PingguSoft/PLEN2/assembly/arm/dsc00886.jpg

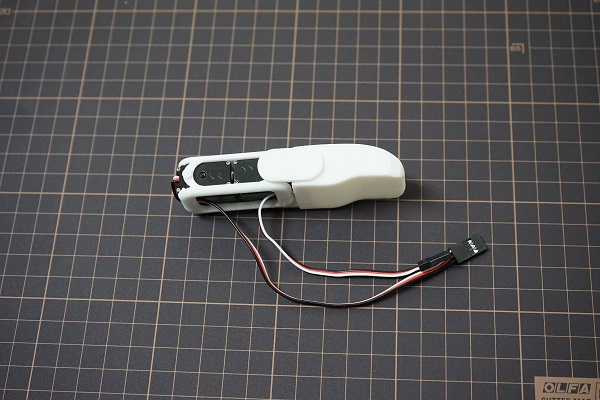
assembly/arm/dsc00886.jpg
