PingguSoft/PLEN2/assembly/arm/dsc00869.jpg

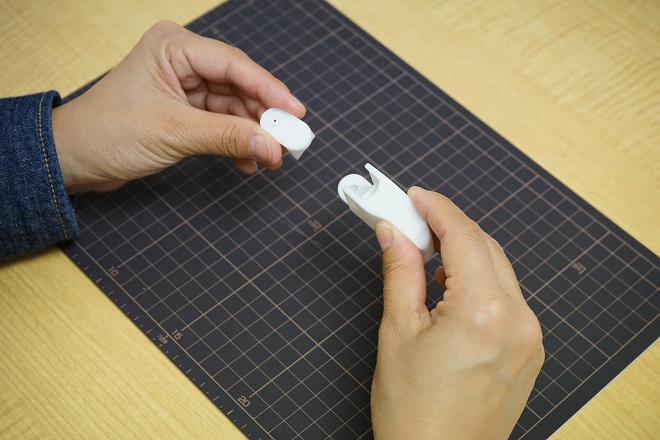
assembly/arm/dsc00869.jpg
