PingguSoft/PLEN2/src/README.md

PLEN2 - Firmware for Arduino (Atmega32u4)
================================================================================

Code name "Cytisus" (version 1.3.0) is now available!

Attention!
---
"Arduino" means compatible board created by us.
Please get it [here](http://shop.plen.jp/) or create yourself.

Copyright (c) 2015,
---
- [Kazuyuki TAKASE](https://github.com/Guvalif), Project manager of the repository.
- [PLEN Project Company Ltd.](http://plen.jp)

API Guide
---
Please check [here](https://plenproject.github.io/plen__firmware_for_Arduino).

Build Enviroment
---
- Windows 8.1 Professional edition
- Windows 7 Home Premium
- Arduino IDE ver.1.6.5-r5
- Sublime Text 3 Build 3083
- [Arduino Unit](https://github.com/mmurdoch/arduinounit)

License
---
This software is released under the MIT License.
