PingguSoft/PLEN2/schematic/esp8266-nodemcu-dev-kit-v1-pins.png

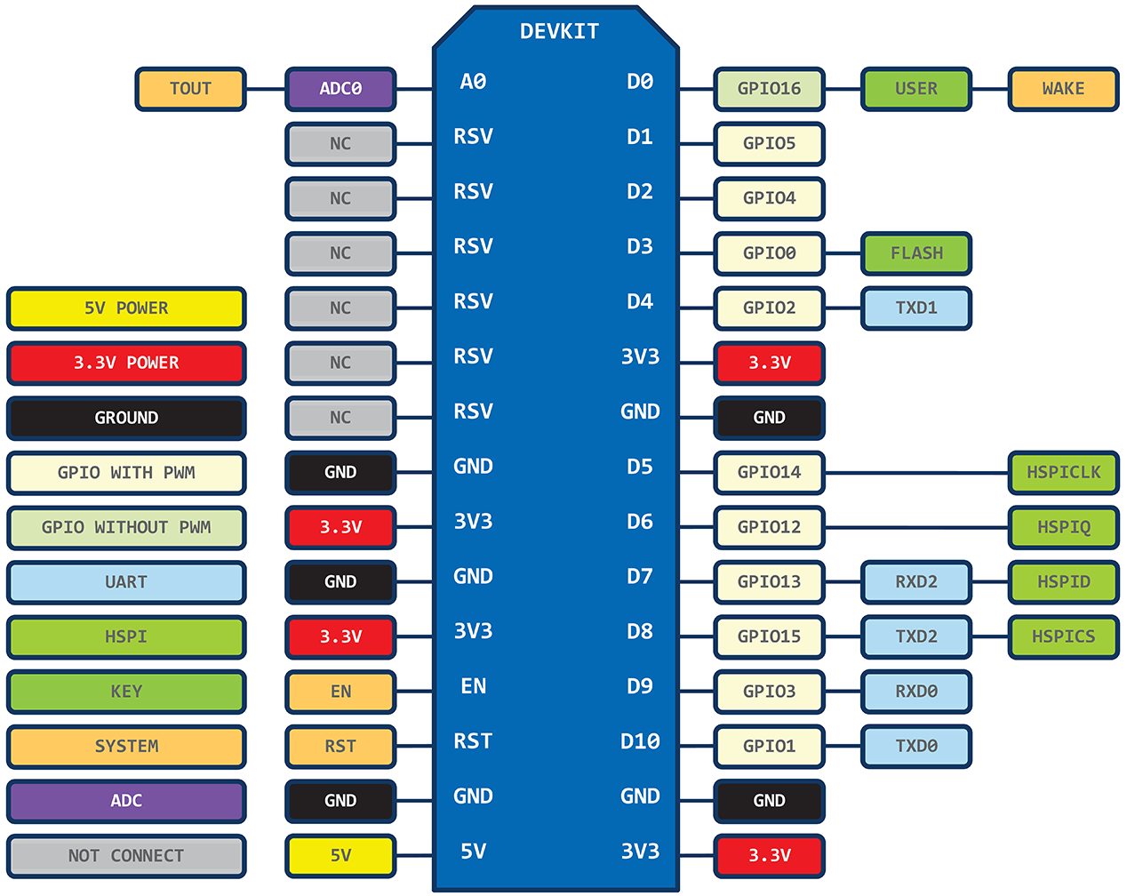
schematic/esp8266-nodemcu-dev-kit-v1-pins.png
