PingguSoft/PLEN2/schematic/loose_board-set.jpg

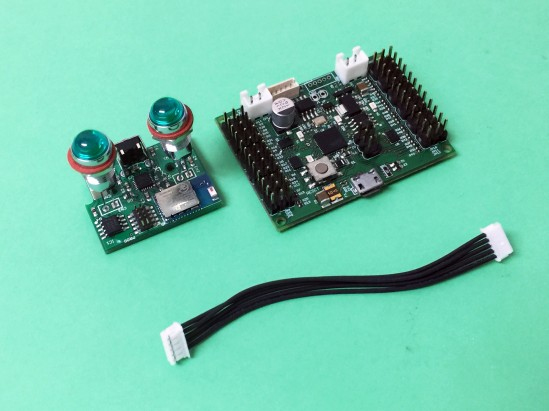
schematic/loose_board-set.jpg
