PingguSoft/PLEN2/schematic/loose_control-board.jpg

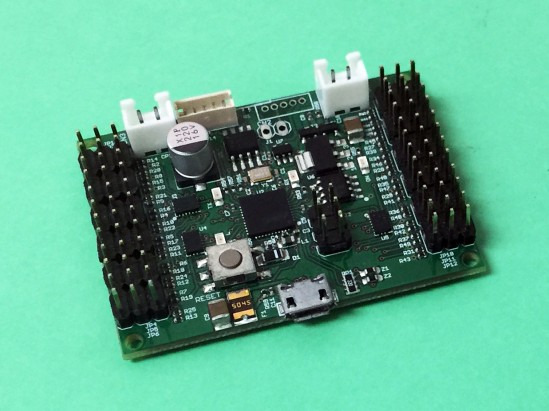
schematic/loose_control-board.jpg
