PingguSoft/PLEN2/schematic/motor_spec/ASV-15-zu1.png

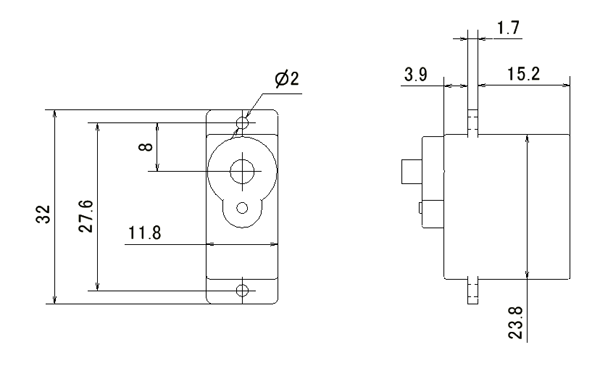
schematic/motor_spec/ASV-15-zu1.png
