PingguSoft/PLEN2/schematic/motor_spec/ASV-15-zu2.png

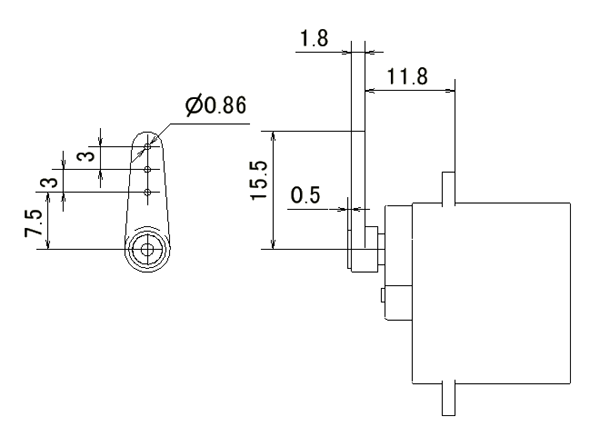
schematic/motor_spec/ASV-15-zu2.png
