PingguSoft/PLEN2/schematic/motor_spec/ASV-15-zu3.png

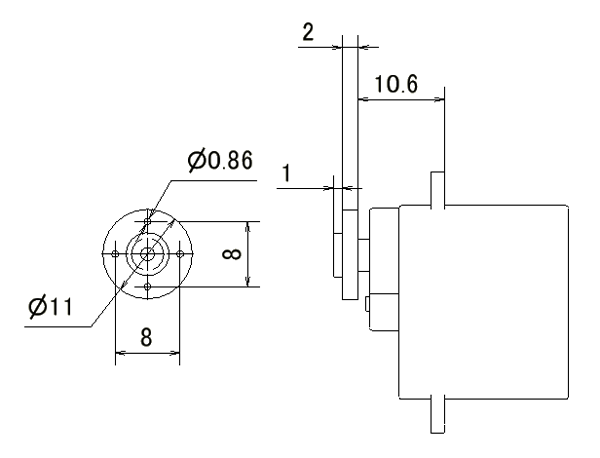
schematic/motor_spec/ASV-15-zu3.png
