PingguSoft/PLEN2/schematic/motor_spec/EMX-SV-0276-DES-1.jpg

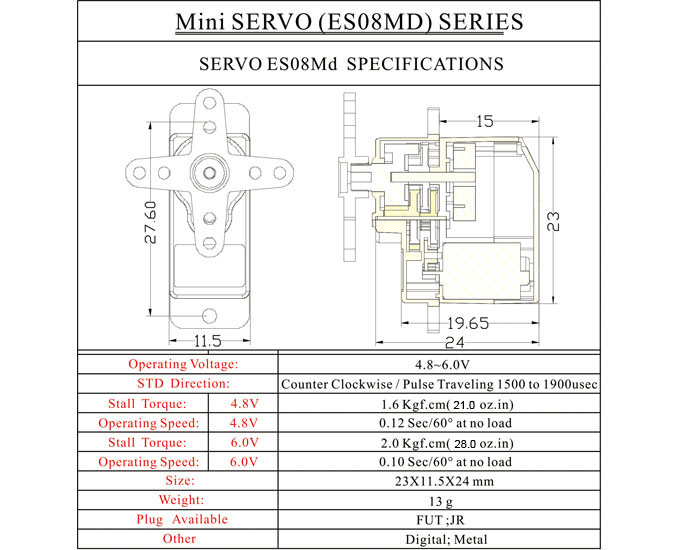
schematic/motor_spec/EMX-SV-0276-DES-1.jpg
