PingguSoft/PLEN2/stl/servo_bracket_shin.stl

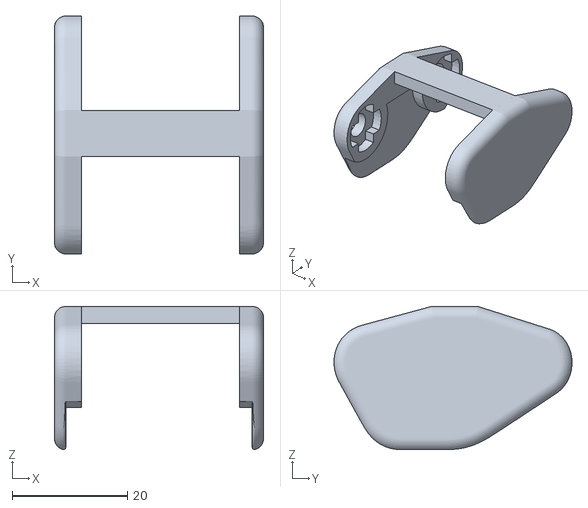
[picture p10: CAD file, 2015-11-30]
stl/servo_bracket_shin.stl
36.4 x 41.4 x 24.9
