PingguSoft/PLEN2/stl/servo_bracket_ankle_2.stl

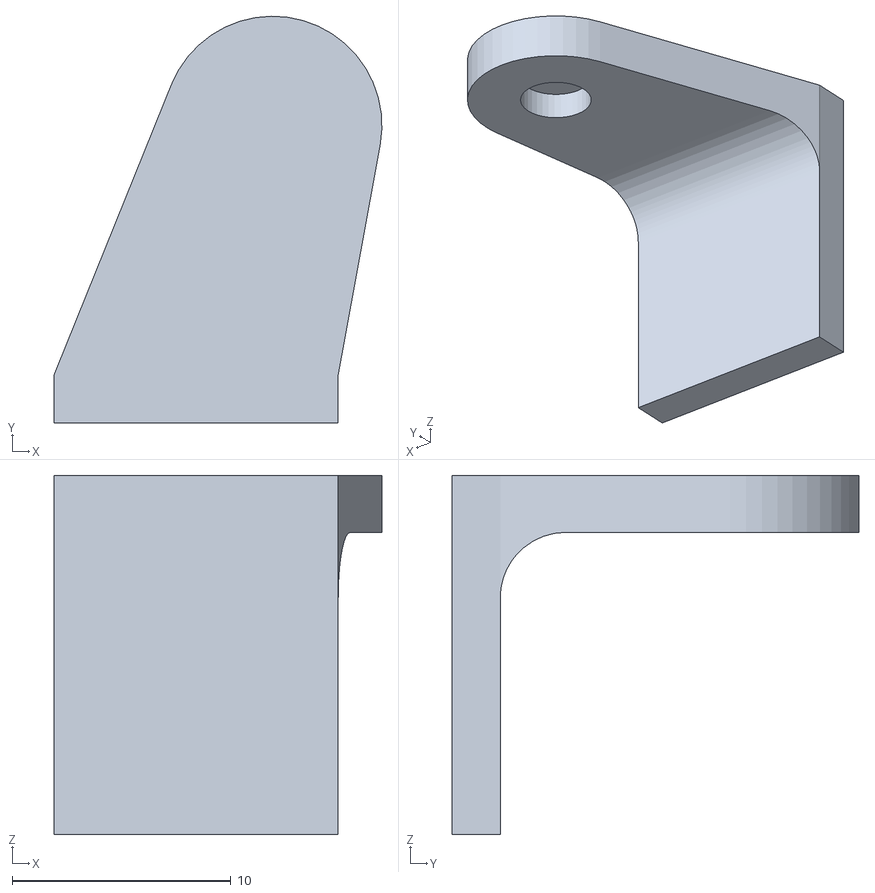
[picture p11: CAD file, 2015-11-30]
stl/servo_bracket_ankle_2.stl
15.0 x 18.6 x 16.4
