PingguSoft/PLEN2/stl/foot.stl

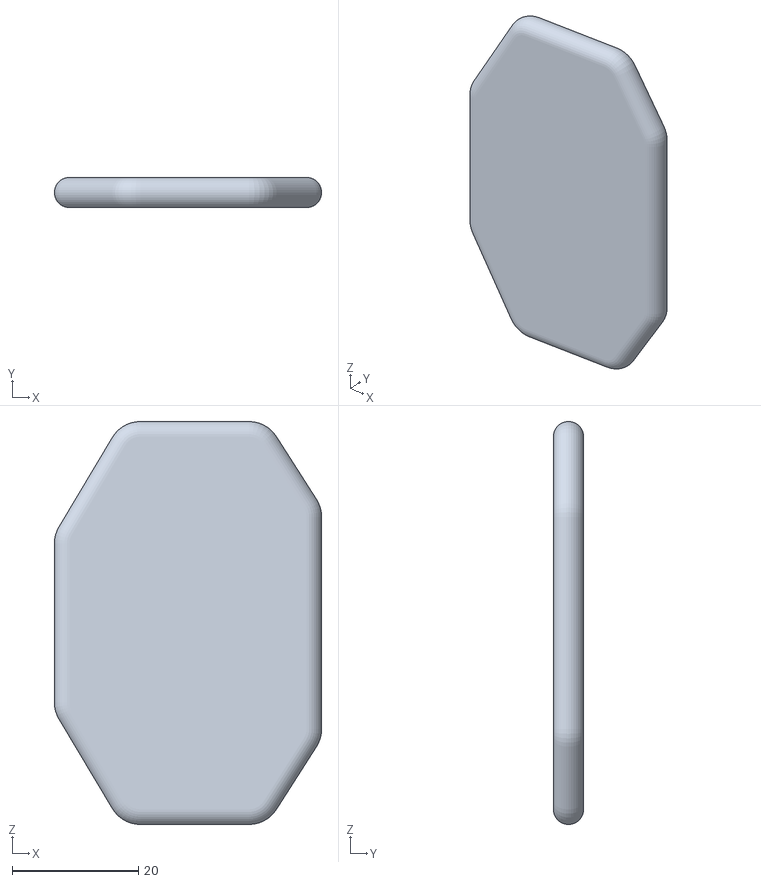
[picture p12: CAD file, 2015-11-30]
stl/foot.stl
42.4 x 4.80 x 63.9
