PingguSoft/PLEN2/stl/servo_bracket_hand.stl

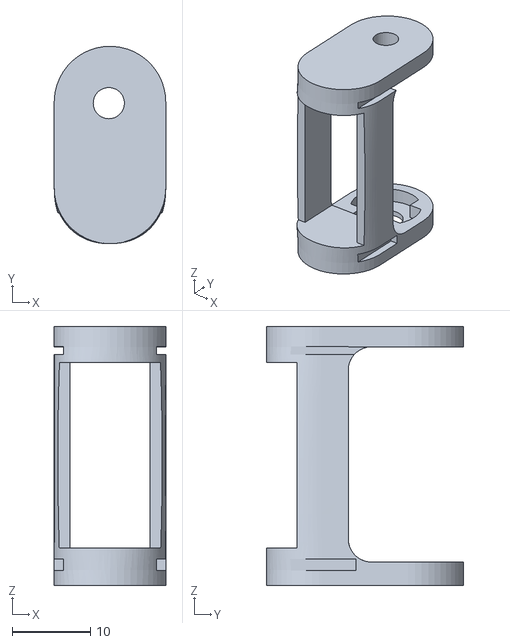
[picture p13: CAD file, 2015-11-30]
stl/servo_bracket_hand.stl
14.3 x 25.3 x 33.2
