PingguSoft/PLEN2/stl/servo_assem_type2.stl

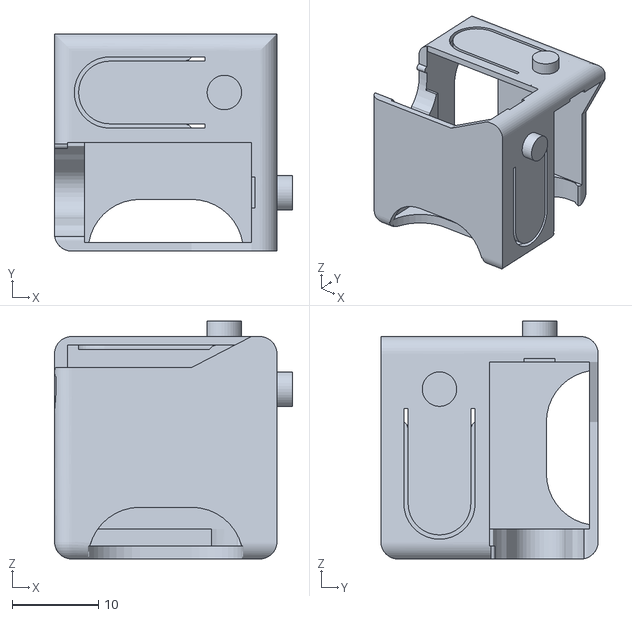
[picture p14: CAD file, 2015-11-30]
stl/servo_assem_type2.stl
27.6 x 25.2 x 27.6
