PingguSoft/PLEN2/stl/neck_rev2.stl

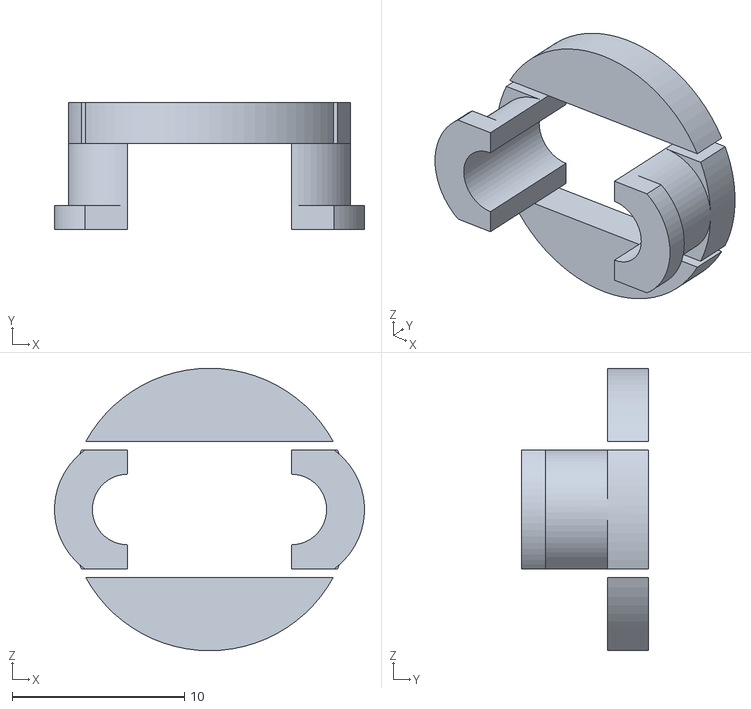
[picture p15: CAD file, 2015-11-30]
stl/neck_rev2.stl
18.0 x 7.40 x 16.4
