PingguSoft/PLEN2/stl/servo_assem_type1.stl

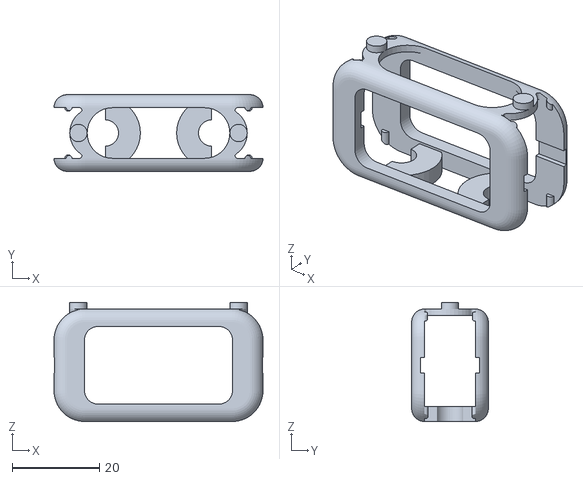
[picture p16: CAD file, 2015-11-30]
stl/servo_assem_type1.stl
47.9 x 17.6 x 27.3
