PingguSoft/PLEN2/stl/chest_0_05.stl

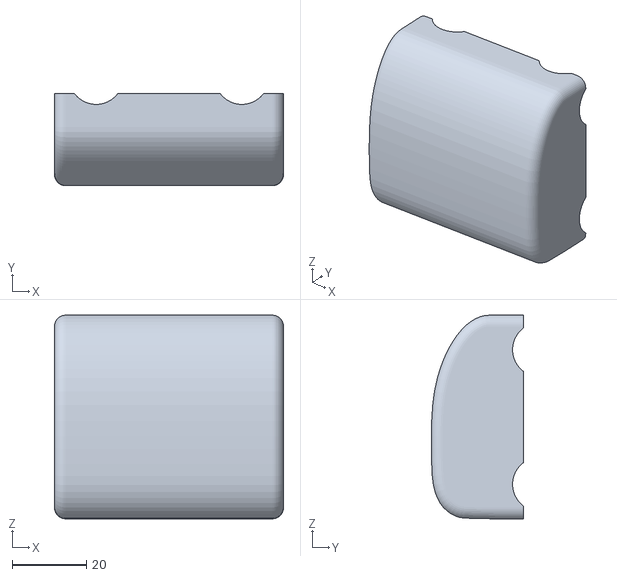
[picture p17: CAD file, 2015-11-30]
stl/chest_0_05.stl
61.6 x 24.9 x 54.8
