PingguSoft/PLEN2/stl/servo_bracket_type1.stl

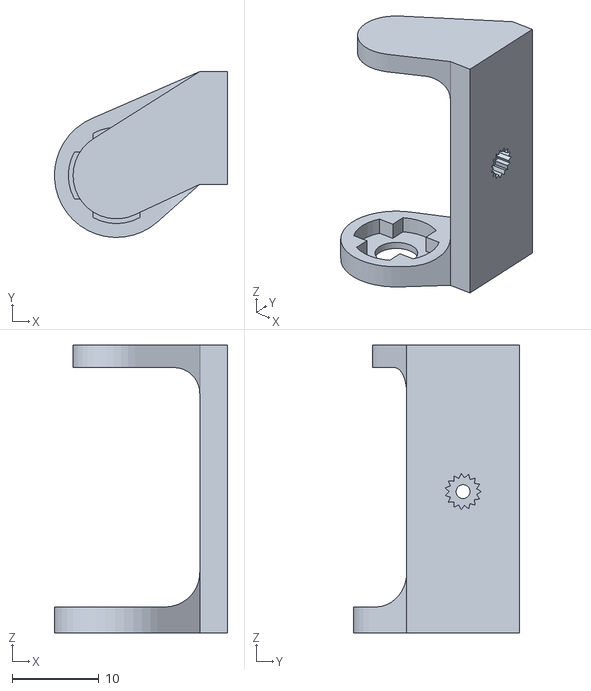
[picture p18: CAD file, 2015-11-30]
stl/servo_bracket_type1.stl
19.9 x 19.1 x 33.2
