PingguSoft/PLEN2/stl/PLEN2.stl

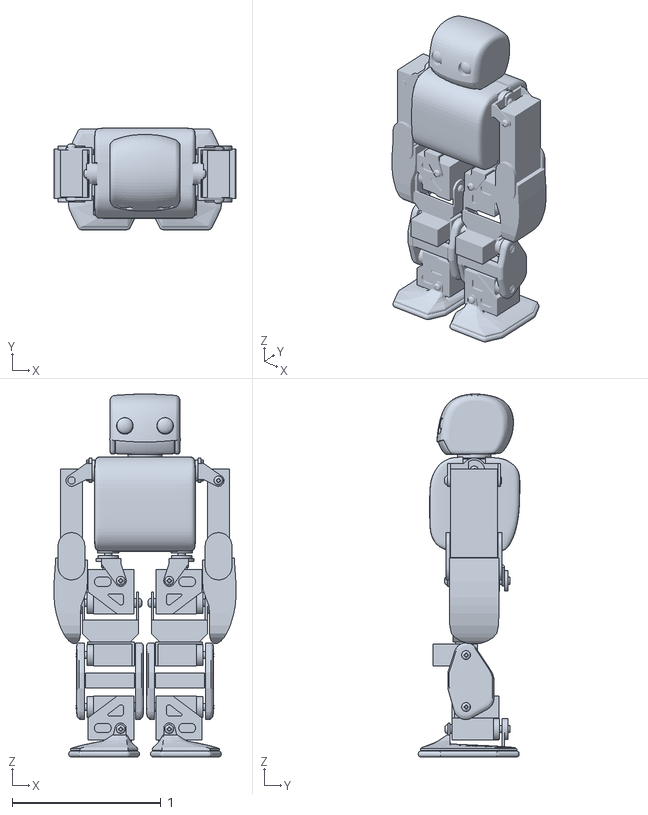
[picture p19: CAD file, 2015-11-30]
stl/PLEN2.stl
1.23 x 0.685 x 2.44
