PingguSoft/PLEN2/stl/barb.stl

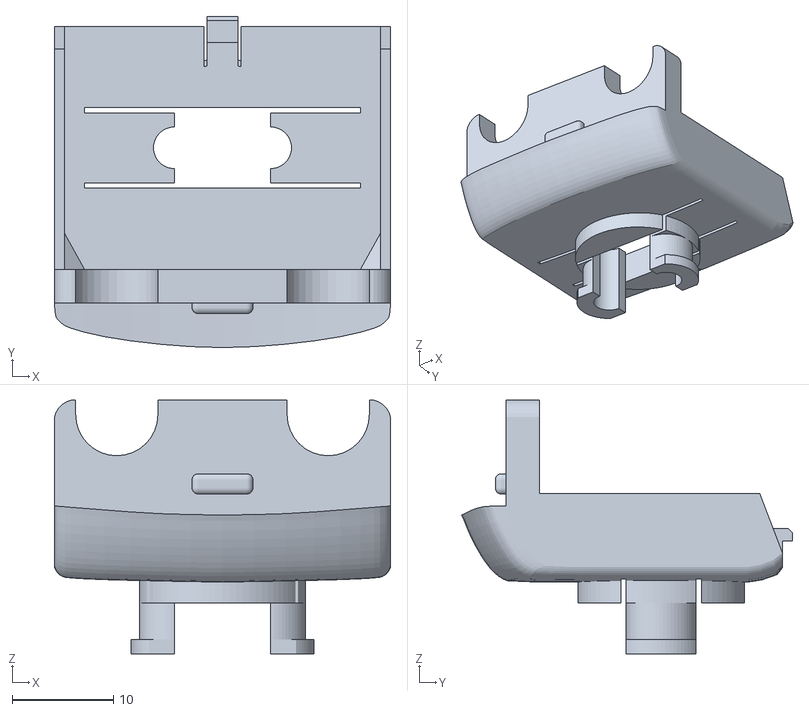
[picture p20: CAD file, 2015-11-30]
stl/barb.stl
33.1 x 32.6 x 25.0
