PingguSoft/PLEN2/stl/servo_bracket_ankle_1_mirror.stl

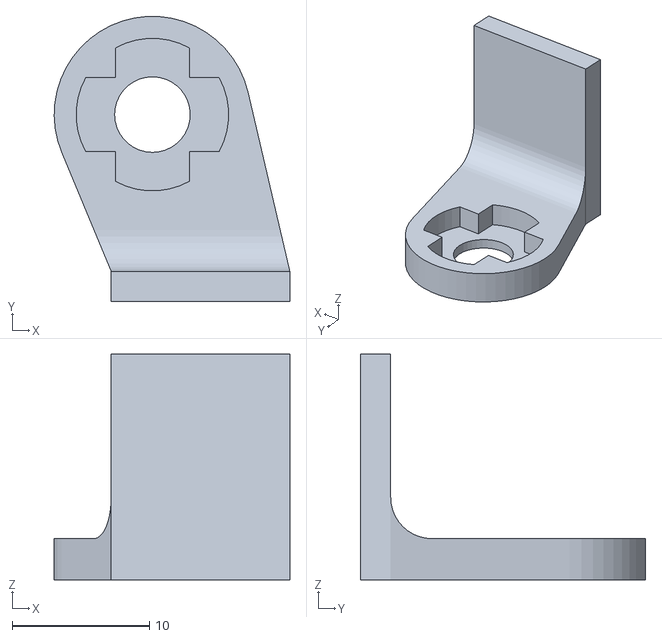
[picture p21: CAD file, 2015-11-30]
stl/servo_bracket_ankle_1_mirror.stl
17.1 x 20.7 x 16.4
