PingguSoft/PLEN2/stl/servo_bracket_elbow_1.stl

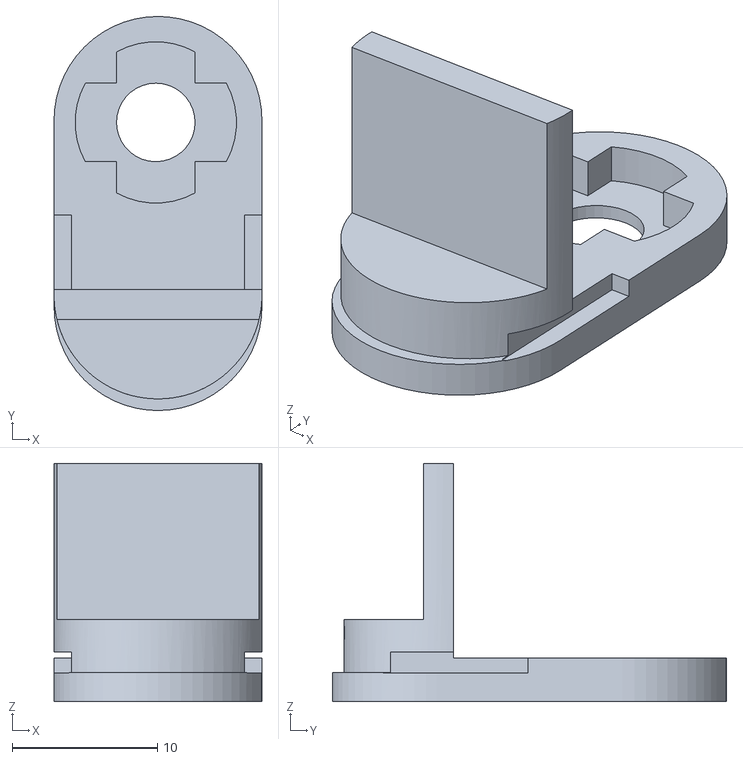
[picture p22: CAD file, 2015-11-30]
stl/servo_bracket_elbow_1.stl
14.3 x 27.1 x 16.4
