PingguSoft/PLEN2/stl/head.stl

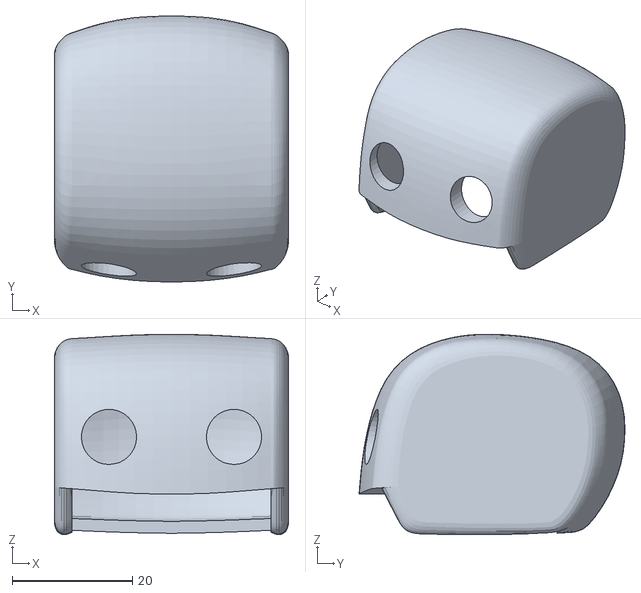
[picture p23: CAD file, 2015-11-30]
stl/head.stl
39.0 x 44.3 x 33.4
