PingguSoft/PLEN2/stl/servo_bracket_knee.stl

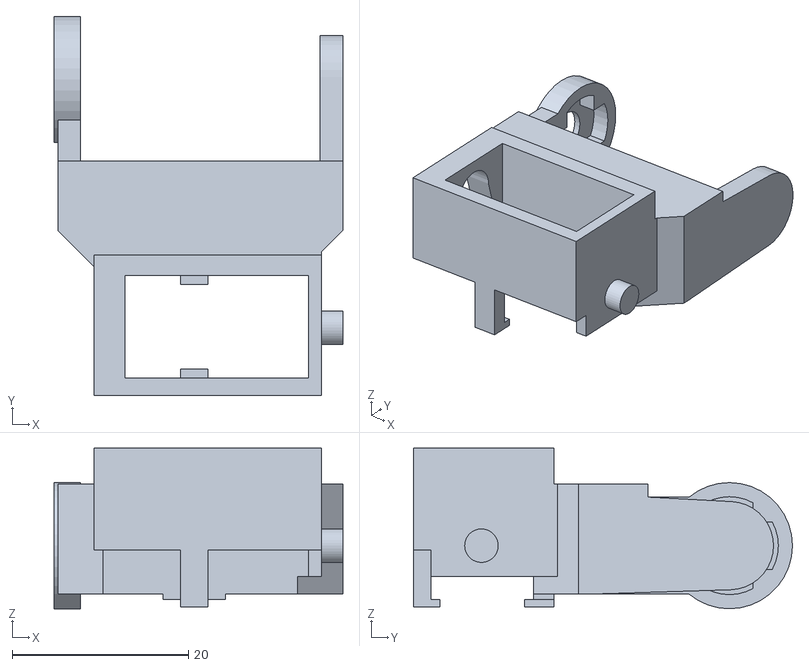
[picture p24: CAD file, 2015-11-30]
stl/servo_bracket_knee.stl
32.7 x 42.9 x 18.2
