PingguSoft/PLEN2/stl/servo_horn_rev1_through_hole.stl

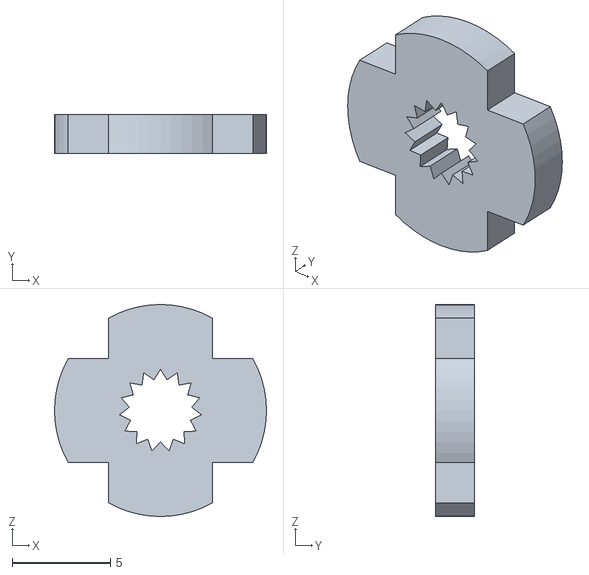
[picture p25: CAD file, 2015-11-30]
stl/servo_horn_rev1_through_hole.stl
10.8 x 2.00 x 10.8
