PingguSoft/PLEN2/stl/motor_fix_body.stl

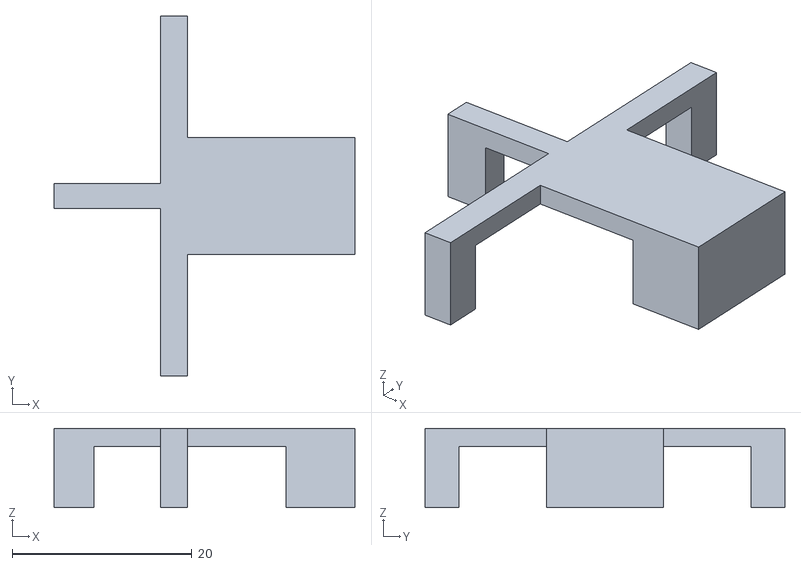
[picture p26: CAD file, 2015-11-30]
stl/motor_fix_body.stl
33.5 x 40.0 x 8.80
