PingguSoft/PLEN2/stl/TJ_es08md_horn.stl

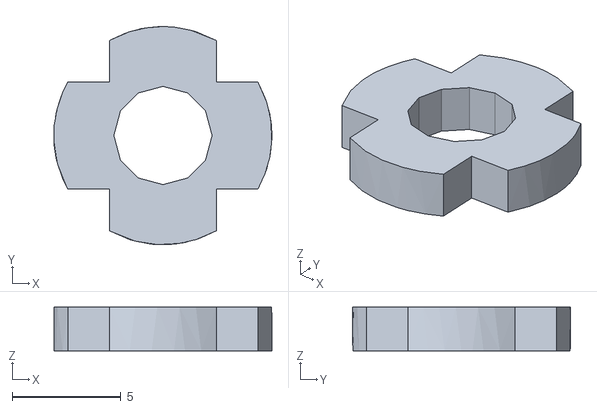
[picture p27: CAD file, 2015-11-30]
stl/TJ_es08md_horn.stl
10.0 x 10.0 x 2.00
