PingguSoft/PLEN2/stl/body_middle_test.stl

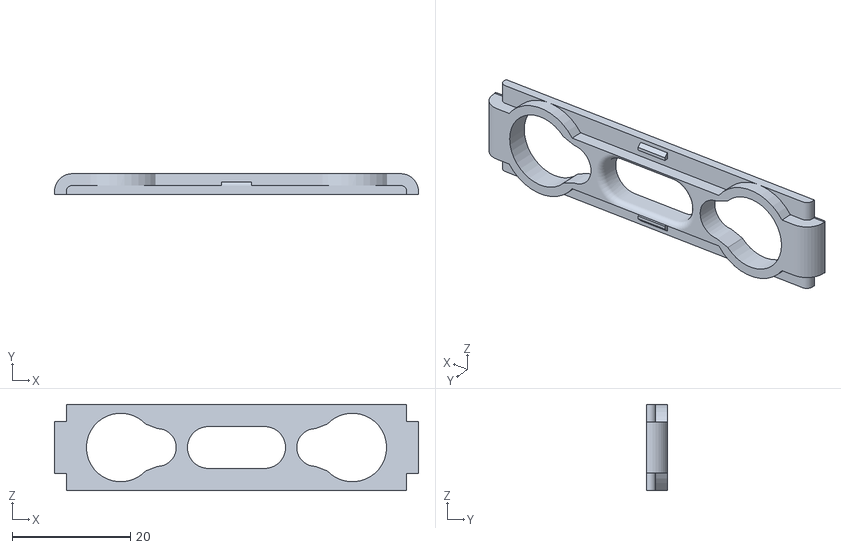
[picture p28: CAD file, 2015-11-30]
stl/body_middle_test.stl
61.6 x 3.50 x 14.6
