PingguSoft/PLEN2/stl/servo_horn_rev1.stl

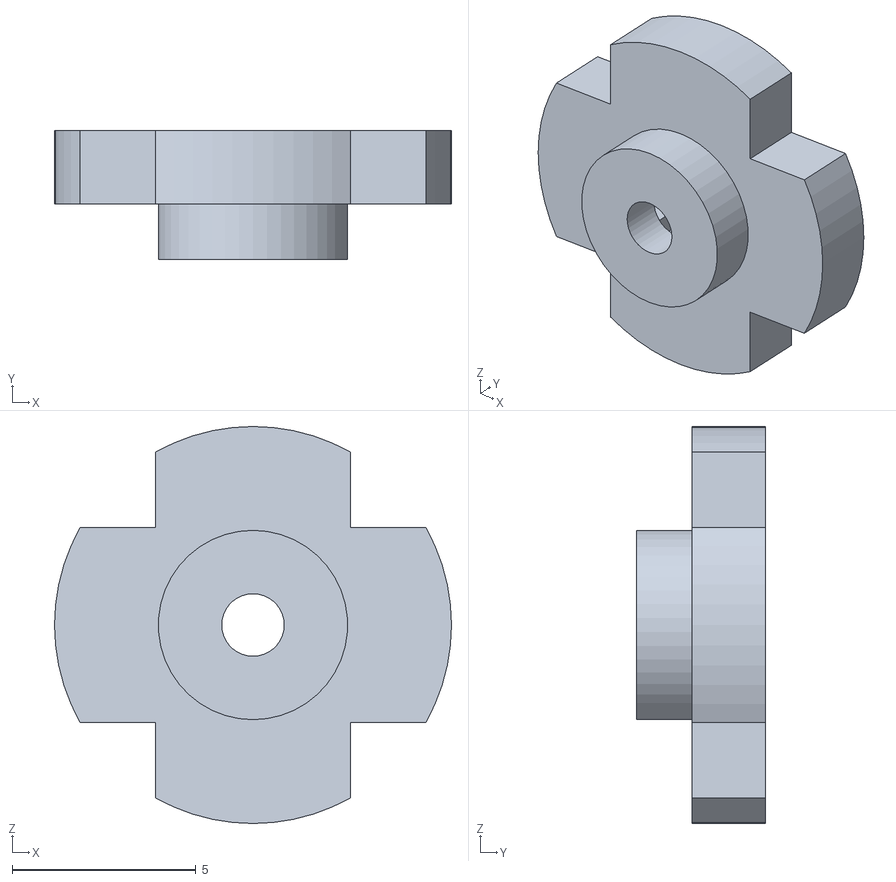
[picture p29: CAD file, 2015-11-30]
stl/servo_horn_rev1.stl
10.8 x 3.50 x 10.8
