PingguSoft/PLEN2/stl/hand.stl

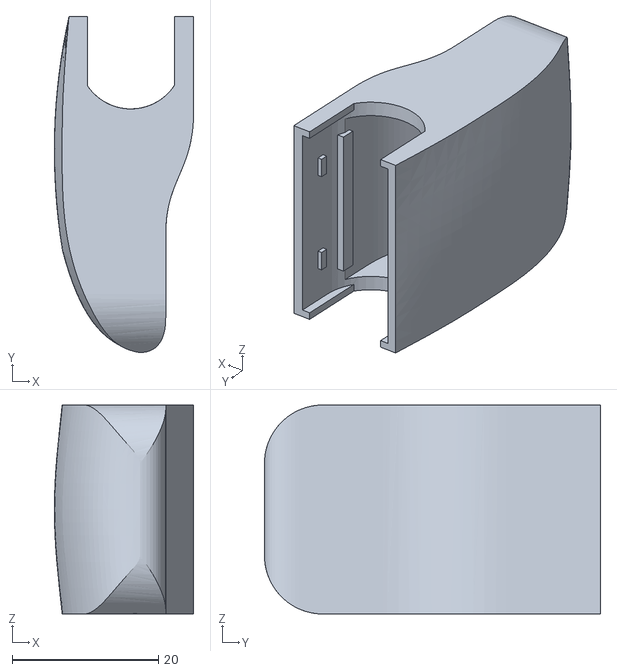
[picture p30: CAD file, 2015-11-30]
stl/hand.stl
19.1 x 46.0 x 28.6
