PingguSoft/PLEN2/stl/body_rear.stl

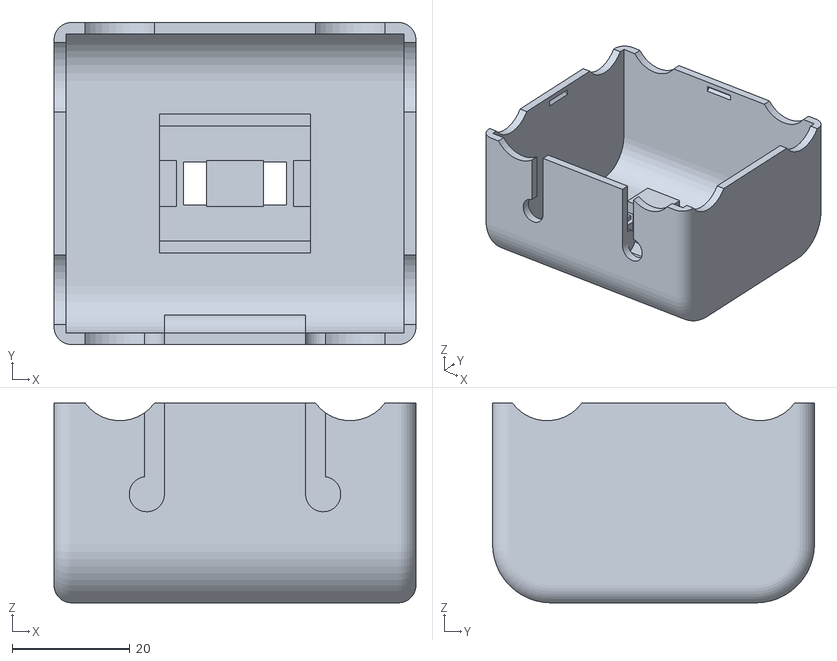
[picture p31: CAD file, 2015-11-30]
stl/body_rear.stl
61.6 x 54.8 x 34.0
