PingguSoft/PLEN2/stl/chest_0_12.stl

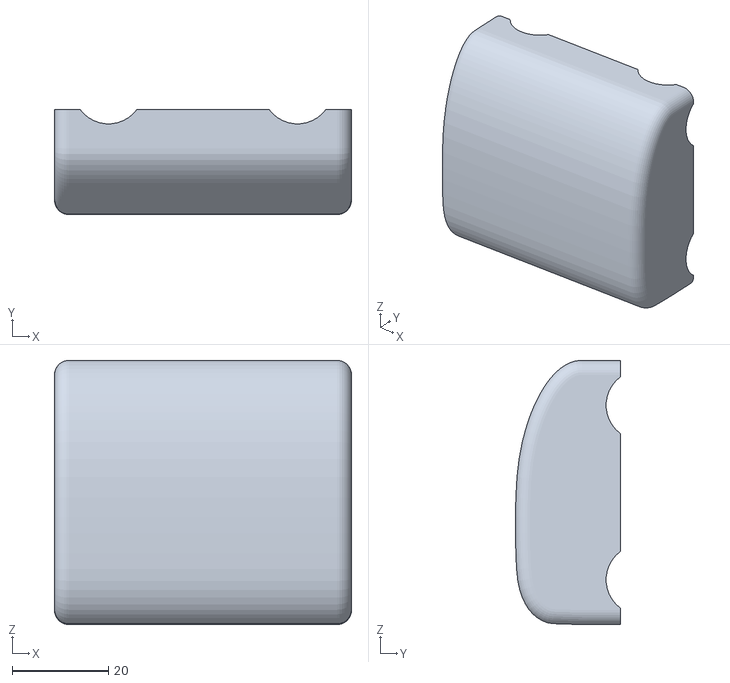
[picture p32: CAD file, 2015-11-30]
stl/chest_0_12.stl
61.6 x 21.8 x 54.8
