PingguSoft/PLEN2/stl/body_middle.stl

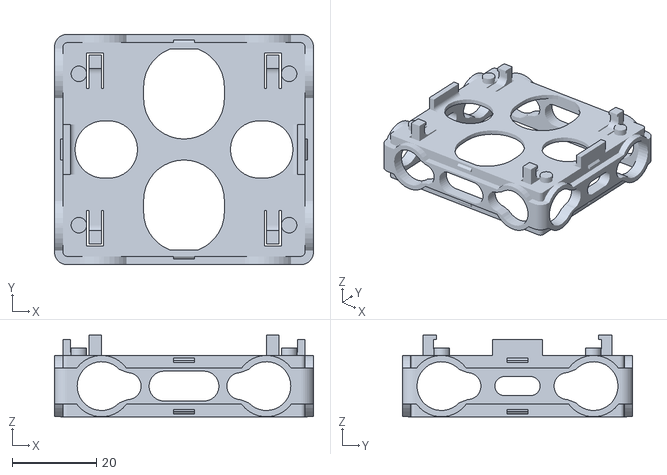
[picture p33: CAD file, 2015-11-30]
stl/body_middle.stl
61.6 x 54.8 x 19.4
