PingguSoft/PLEN2/stl/servo_bracket_elbow_2.stl

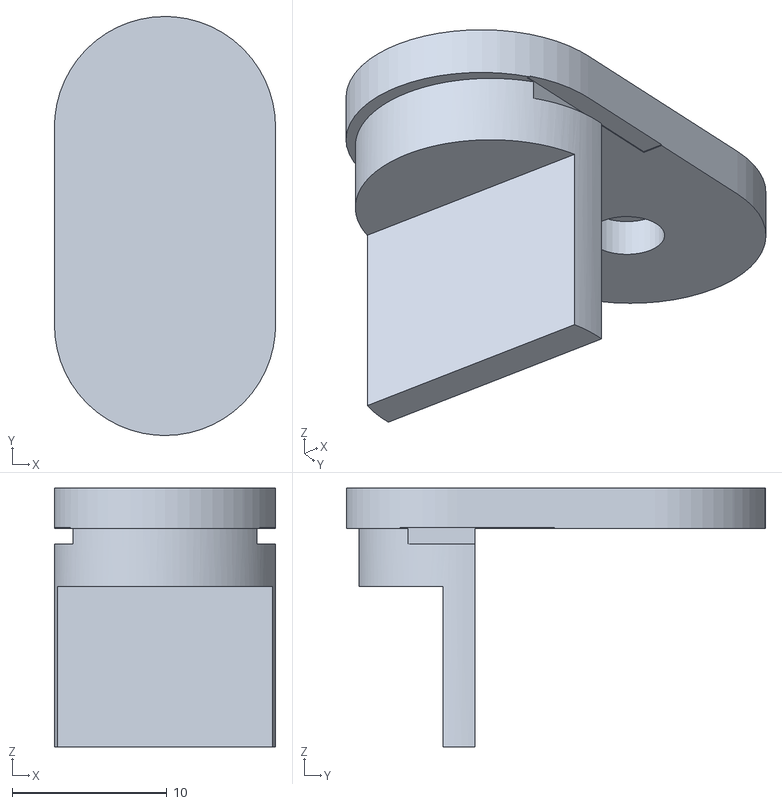
[picture p34: CAD file, 2015-11-30]
stl/servo_bracket_elbow_2.stl
14.3 x 27.1 x 16.7
