PingguSoft/PLEN2/(list of files, cad)

Other CAD files:
stl/servo_bracket_type1_mirror.stl
stl/servo_bracket_ankle_2_mirror.stl
stl/foot_mirror.stl
stl/servo_bracket_shin_mirror.stl
stl/servo_assem_type2_mirror.stl
stl/servo_bracket_knee_mirror.stl
stl/servo_bracket_ankle_1.stl
