PingguSoft/PLEN2/assembly/arm/dsc00866.jpg

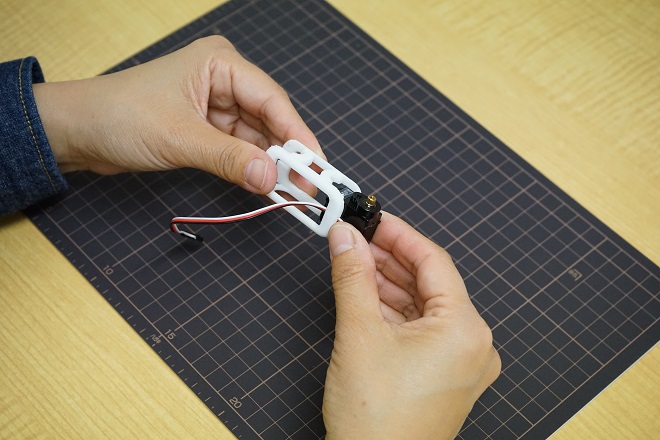
assembly/arm/dsc00866.jpg
