PingguSoft/PLEN2/assembly/arm/dsc00867.jpg

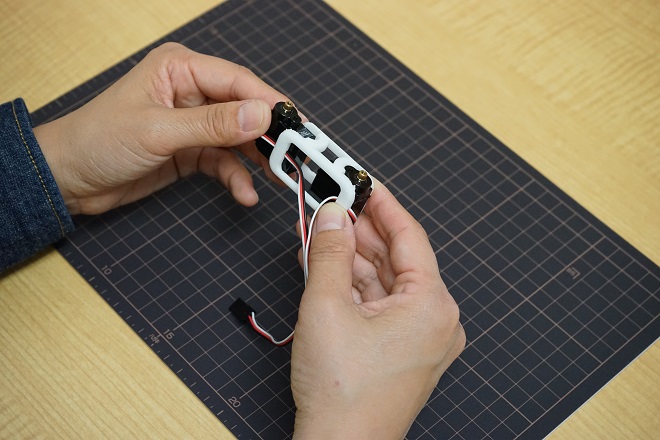
assembly/arm/dsc00867.jpg
