PingguSoft/PLEN2/assembly/arm/dsc00868.jpg

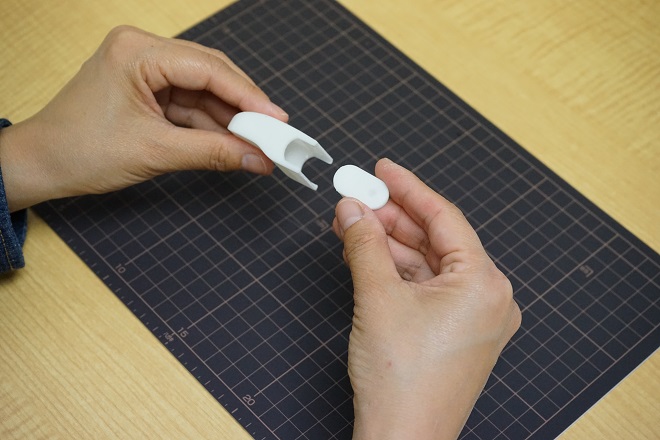
assembly/arm/dsc00868.jpg
