PingguSoft/PLEN2/assembly/arm/dsc00871.jpg

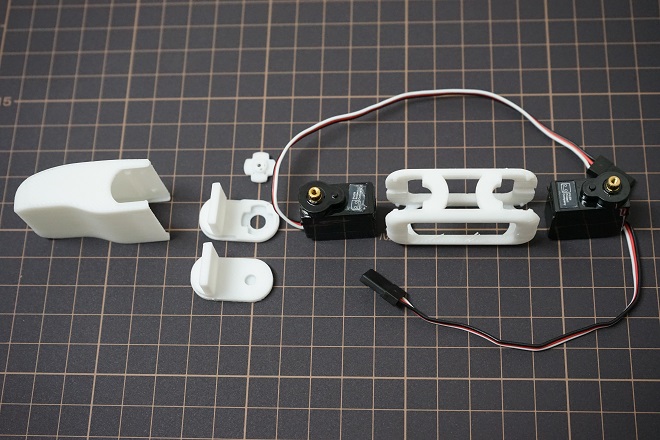
assembly/arm/dsc00871.jpg
