PingguSoft/PLEN2/assembly/arm/dsc00873.jpg

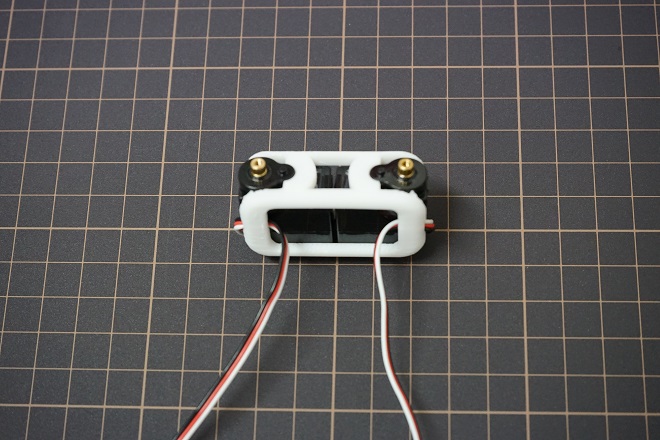
assembly/arm/dsc00873.jpg
