PingguSoft/PLEN2/assembly/arm/dsc00885.jpg

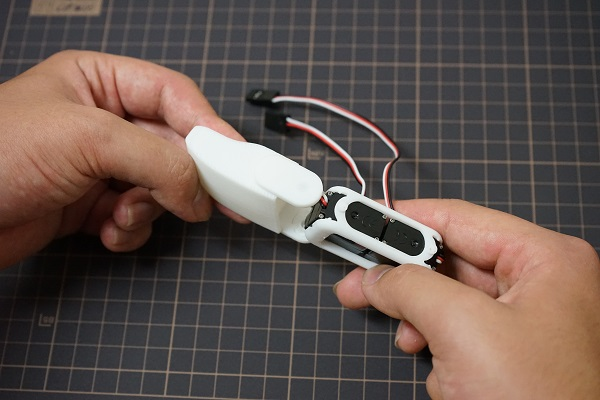
assembly/arm/dsc00885.jpg
