PingguSoft/PLEN2/assembly/leg/dsc00895.jpg

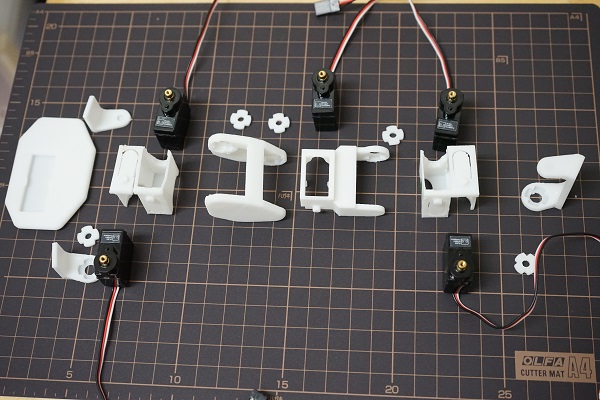
assembly/leg/dsc00895.jpg
