PingguSoft/PLEN2/assembly/leg/dsc00898.jpg

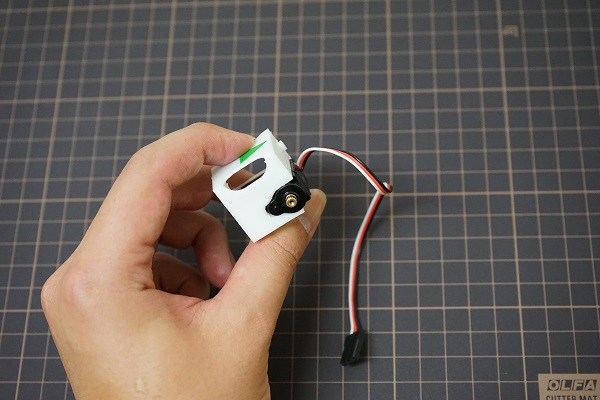
assembly/leg/dsc00898.jpg
