PingguSoft/PLEN2/assembly/leg/dsc00900.jpg

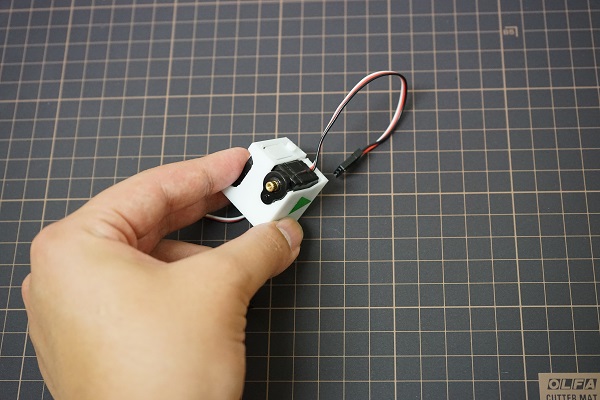
assembly/leg/dsc00900.jpg
