PingguSoft/PLEN2/assembly/leg/dsc00913.jpg

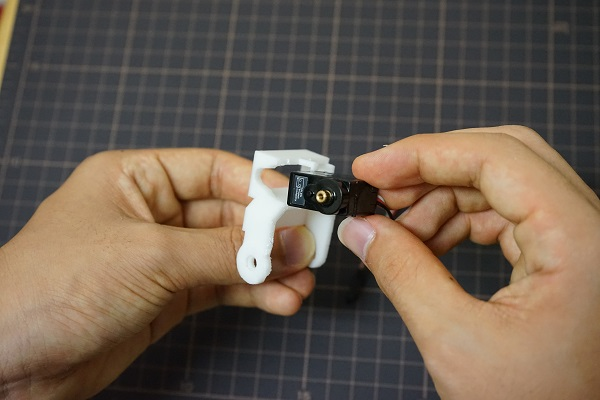
assembly/leg/dsc00913.jpg
