PingguSoft/PLEN2/assembly/leg/dsc00914.jpg

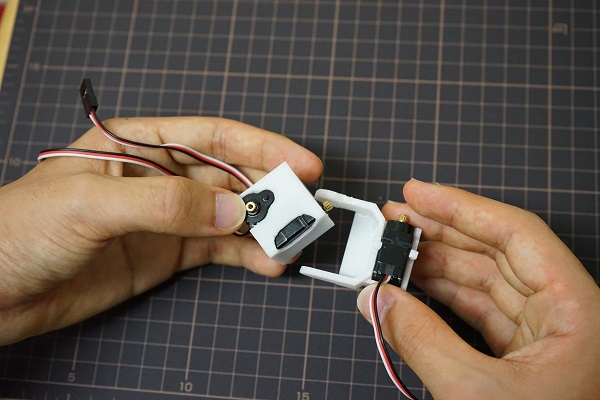
assembly/leg/dsc00914.jpg
