PingguSoft/PLEN2/assembly/leg/dsc00919.jpg

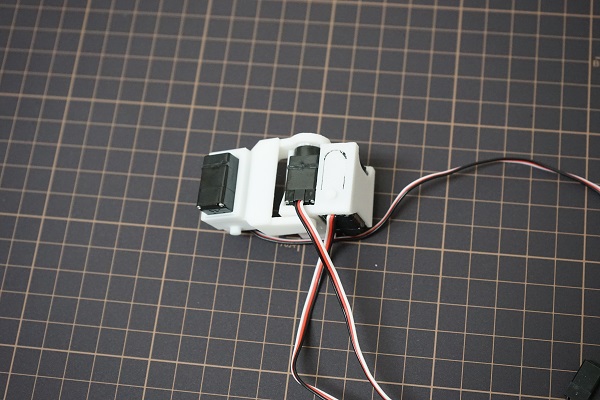
assembly/leg/dsc00919.jpg
