PingguSoft/PLEN2/assembly/leg/dsc00927.jpg

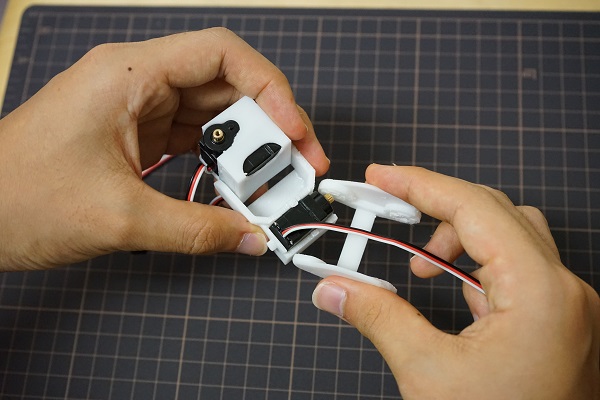
assembly/leg/dsc00927.jpg
