PingguSoft/PLEN2/assembly/leg/dsc00931.jpg

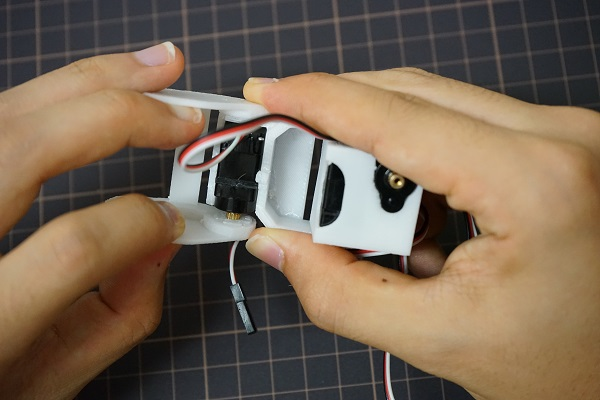
assembly/leg/dsc00931.jpg
