PingguSoft/PLEN2/assembly/leg/dsc00933.jpg

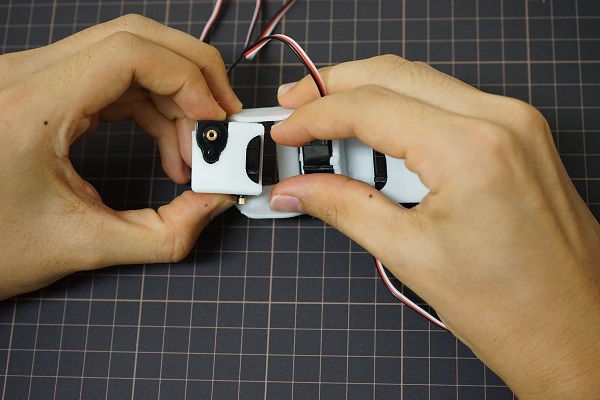
assembly/leg/dsc00933.jpg
