PingguSoft/PLEN2/assembly/leg/dsc00937.jpg

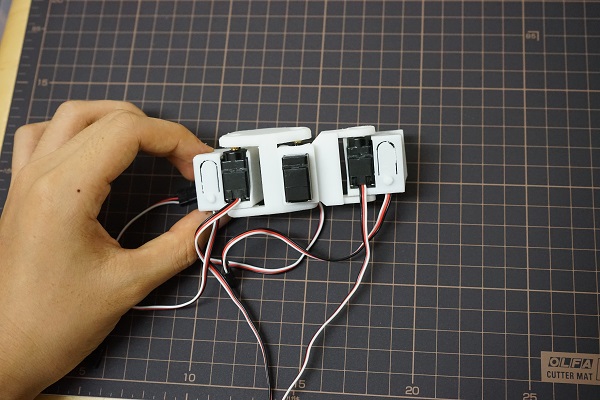
assembly/leg/dsc00937.jpg
