PingguSoft/PLEN2/assembly/leg/dsc00938.jpg

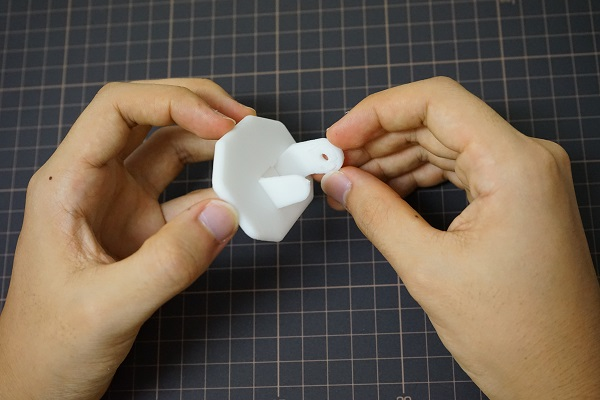
assembly/leg/dsc00938.jpg
