PingguSoft/PLEN2/assembly/leg/dsc00940.jpg

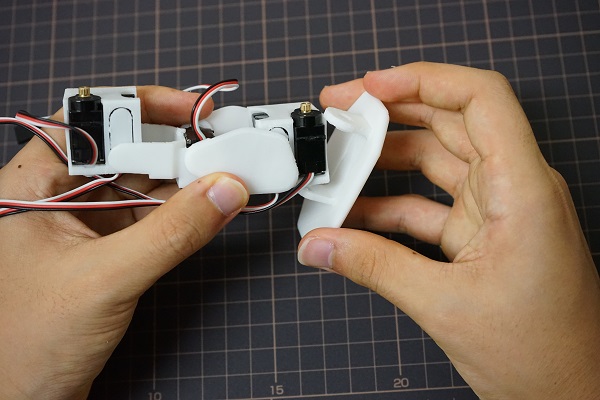
assembly/leg/dsc00940.jpg
