PingguSoft/PLEN2/assembly/leg/dsc00943.jpg

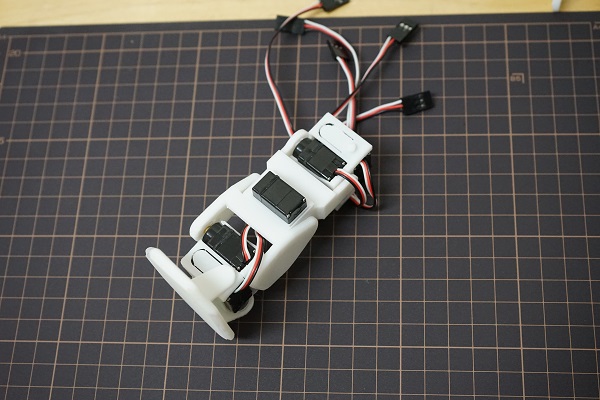
assembly/leg/dsc00943.jpg
