PingguSoft/PLEN2/assembly/leg/dsc01029.jpg

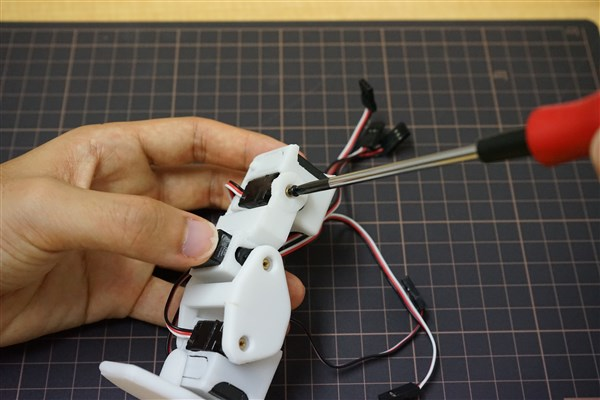
assembly/leg/dsc01029.jpg
