PingguSoft/PLEN2/schematic/headboard/plen_headboard.pdf

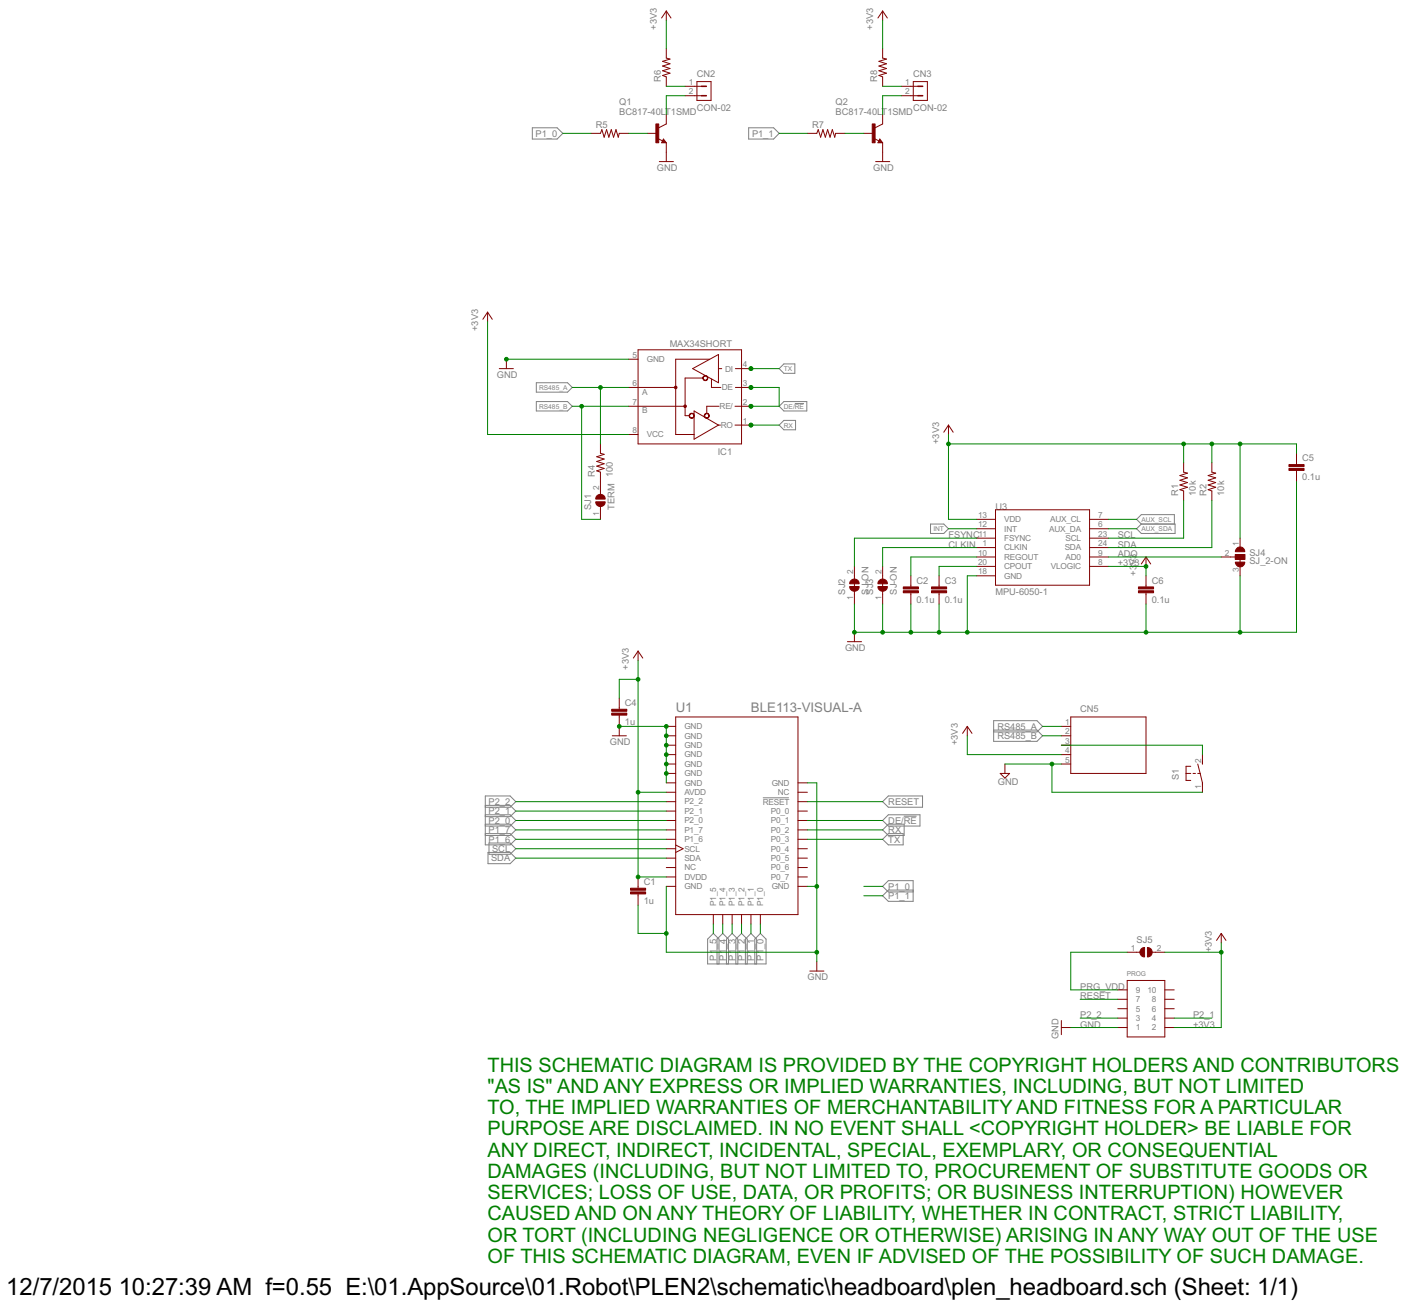
[picture p55: page 1]

GND GND GND GND GND GND GND

THIS SCHEMATIC DIAGRAM IS PROVIDED BY THE COPYRIGHT HOLDERS AND CONTRIBUTORS
"AS IS" AND ANY EXPRESS OR IMPLIED WARRANTIES, INCLUDING, BUT NOT LIMITED
TO, THE IMPLIED WARRANTIES OF MERCHANTABILITY AND FITNESS FOR A PARTICULAR
PURPOSE ARE DISCLAIMED. IN NO EVENT SHALL <COPYRIGHT HOLDER> BE LIABLE FOR
ANY DIRECT, INDIRECT, INCIDENTAL, SPECIAL, EXEMPLARY, OR CONSEQUENTIAL
DAMAGES (INCLUDING, BUT NOT LIMITED TO, PROCUREMENT OF SUBSTITUTE GOODS OR
SERVICES; LOSS OF USE, DATA, OR PROFITS; OR BUSINESS INTERRUPTION) HOWEVER
CAUSED AND ON ANY THEORY OF LIABILITY, WHETHER IN CONTRACT, STRICT LIABILITY, OR TORT (INCLUDING NEGLIGENCE OR OTHERWISE) ARISING IN ANY WAY OUT OF THE USE

OF THIS SCHEMATIC DIAGRAM, EVEN IF ADVISED OF THE POSSIBILITY OF SUCH DAMAGE.

12/7/2015 10:27:39 AM f=0.55 E:\01.AppSource\01.Robot\PLEN2\schematic\headboard\plen_headboard.sch (Sheet: 1/1)
