PingguSoft/PLEN2/schematic/baseboard/plen_baseboard.pdf

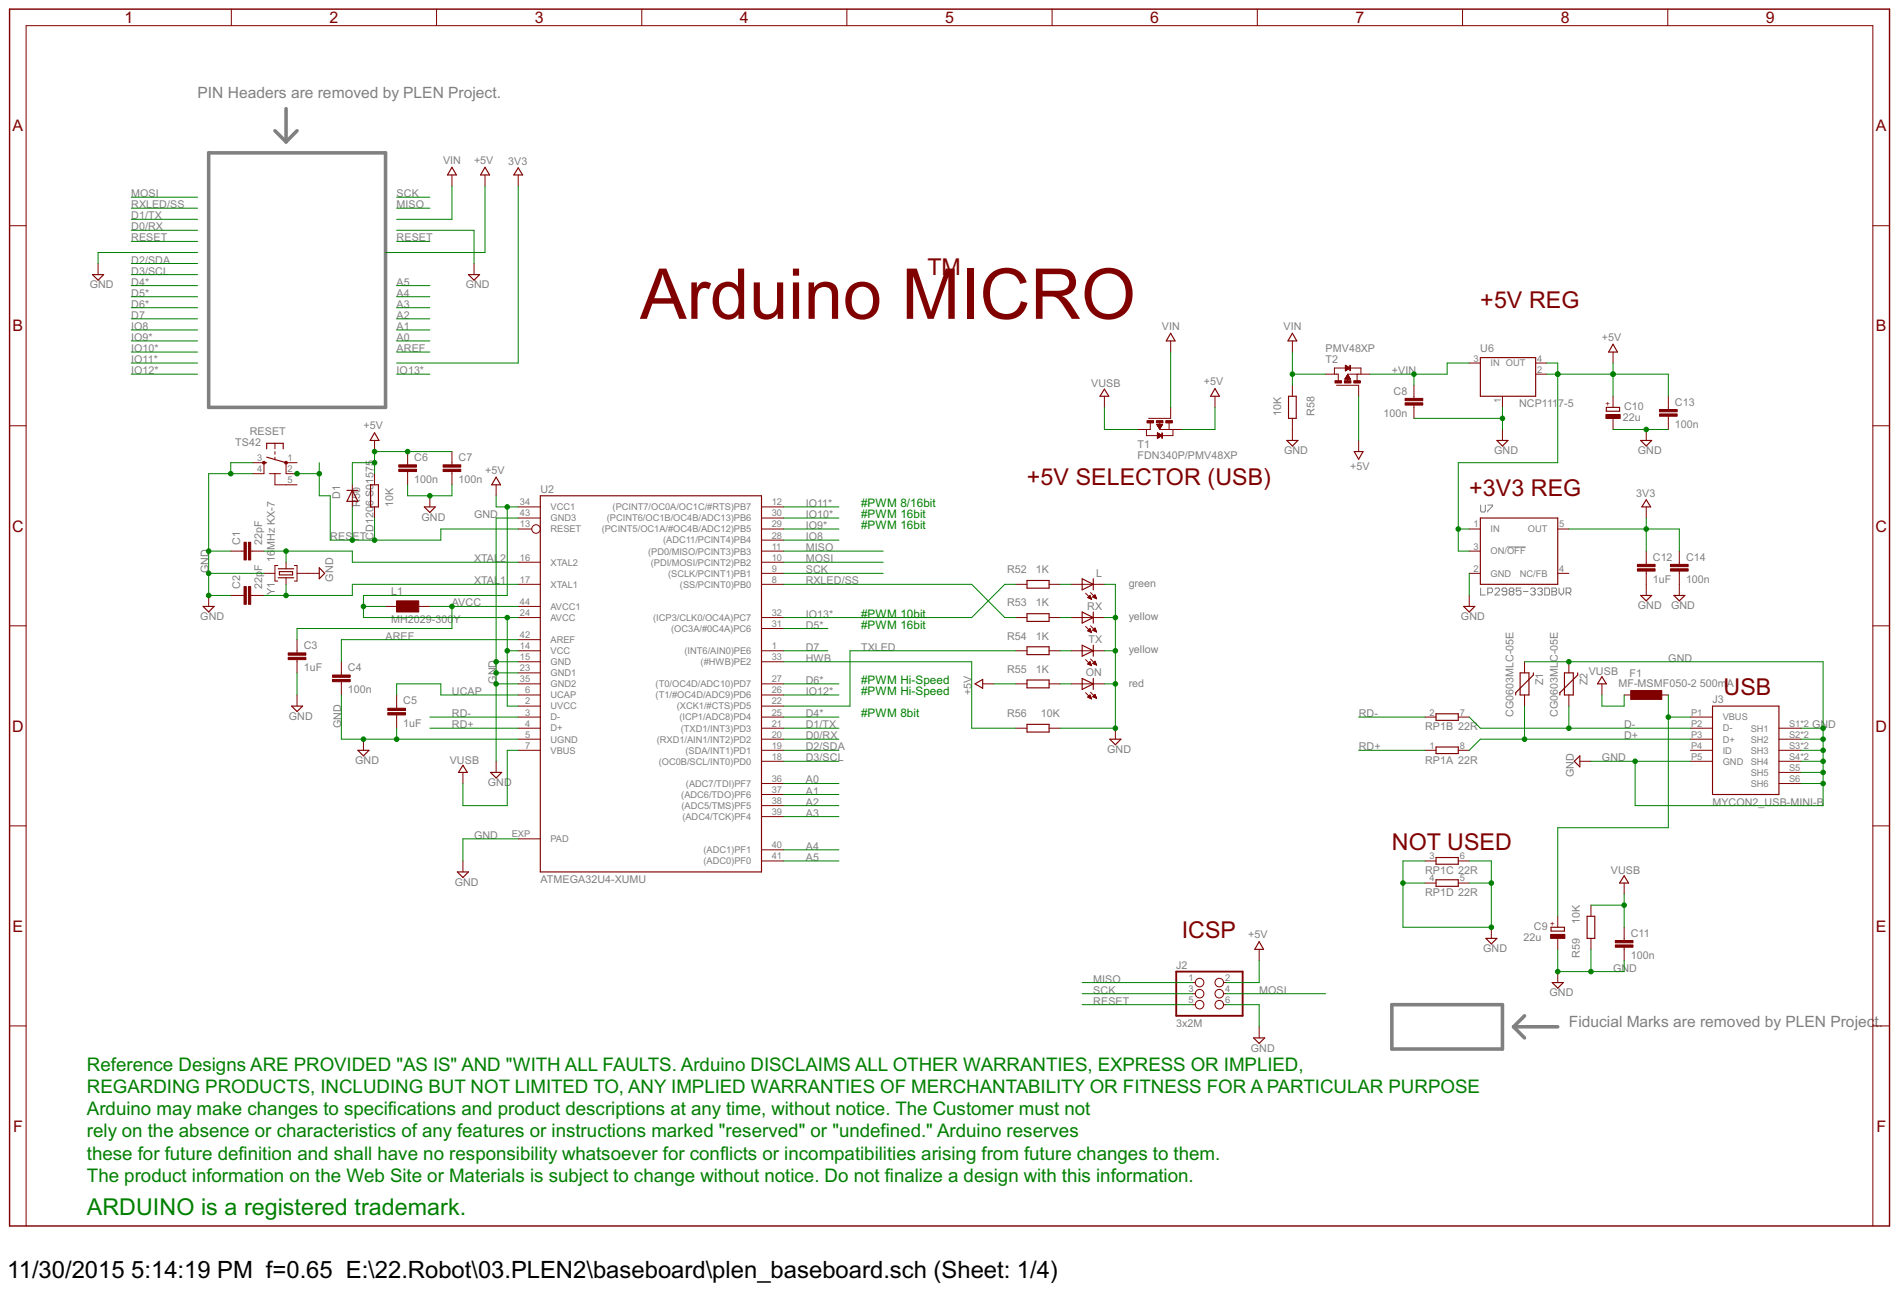
[picture p56: page 1]

#PWM Hi-Speed
#PWM 8bit #PWM Hi-Speed

Fiducial Marks are removed by PLEN Project.

Reference Designs ARE PROVIDED "AS IS" AND "WITH ALL FAULTS. Arduino DISCLAIMS ALL OTHER WARRANTIES, EXPRESS OR IMPLIED, Arduino may make changes to specifications and product descriptions at any time, without notice. The Customer must not
REGARDING PRODUCTS, INCLUDING BUT NOT LIMITED TO, ANY IMPLIED WARRANTIES OF MERCHANTABILITY OR FITNESS FOR A PARTICULAR PURPOSE

rely on the absence or characteristics of any features or instructions marked "reserved" or "undefined." Arduino reserves
these for future definition and shall have no responsibility whatsoever for conflicts or incompatibilities arising from future changes to them. The product information on the Web Site or Materials is subject to change without notice. Do not finalize a design with this information. ARDUINO is a registered trademark.

11/30/2015 5:14:19 PM f=0.65 E:\22.Robot\03.PLEN2\baseboard\plen_baseboard.sch (Sheet: 1/4)

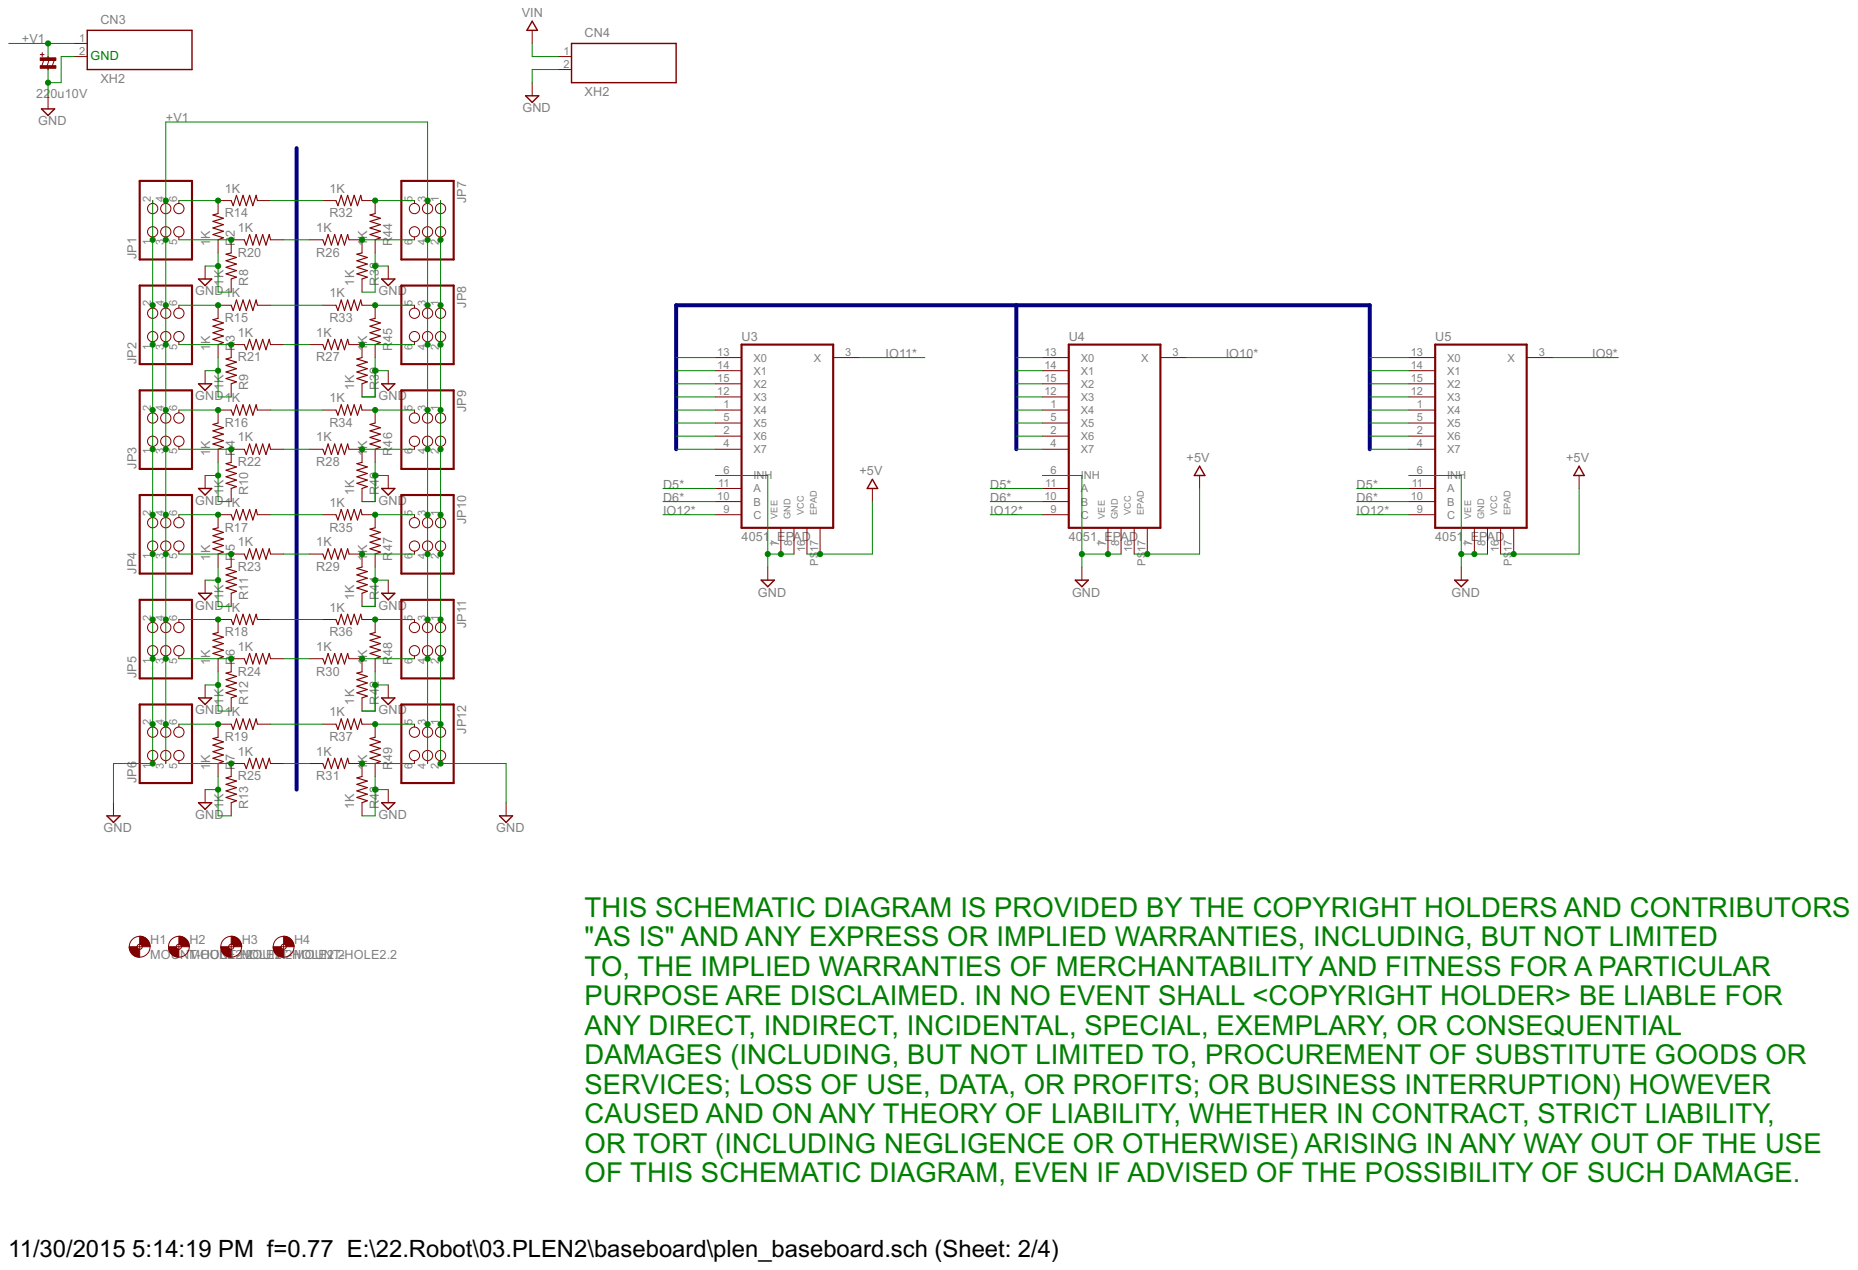
[picture p57: page 2]

THIS SCHEMATIC DIAGRAM IS PROVIDED BY THE COPYRIGHT HOLDERS AND CONTRIBUTORS
"AS IS" AND ANY EXPRESS OR IMPLIED WARRANTIES, INCLUDING, BUT NOT LIMITED
TO, THE IMPLIED WARRANTIES OF MERCHANTABILITY AND FITNESS FOR A PARTICULAR
PURPOSE ARE DISCLAIMED. IN NO EVENT SHALL <COPYRIGHT HOLDER> BE LIABLE FOR
ANY DIRECT, INDIRECT, INCIDENTAL, SPECIAL, EXEMPLARY, OR CONSEQUENTIAL
DAMAGES (INCLUDING, BUT NOT LIMITED TO, PROCUREMENT OF SUBSTITUTE GOODS OR
SERVICES; LOSS OF USE, DATA, OR PROFITS; OR BUSINESS INTERRUPTION) HOWEVER
CAUSED AND ON ANY THEORY OF LIABILITY, WHETHER IN CONTRACT, STRICT LIABILITY, OR TORT (INCLUDING NEGLIGENCE OR OTHERWISE) ARISING IN ANY WAY OUT OF THE USE

OF THIS SCHEMATIC DIAGRAM, EVEN IF ADVISED OF THE POSSIBILITY OF SUCH DAMAGE.

11/30/2015 5:14:19 PM f=0.77 E:\22.Robot\03.PLEN2\baseboard\plen_baseboard.sch (Sheet: 2/4)

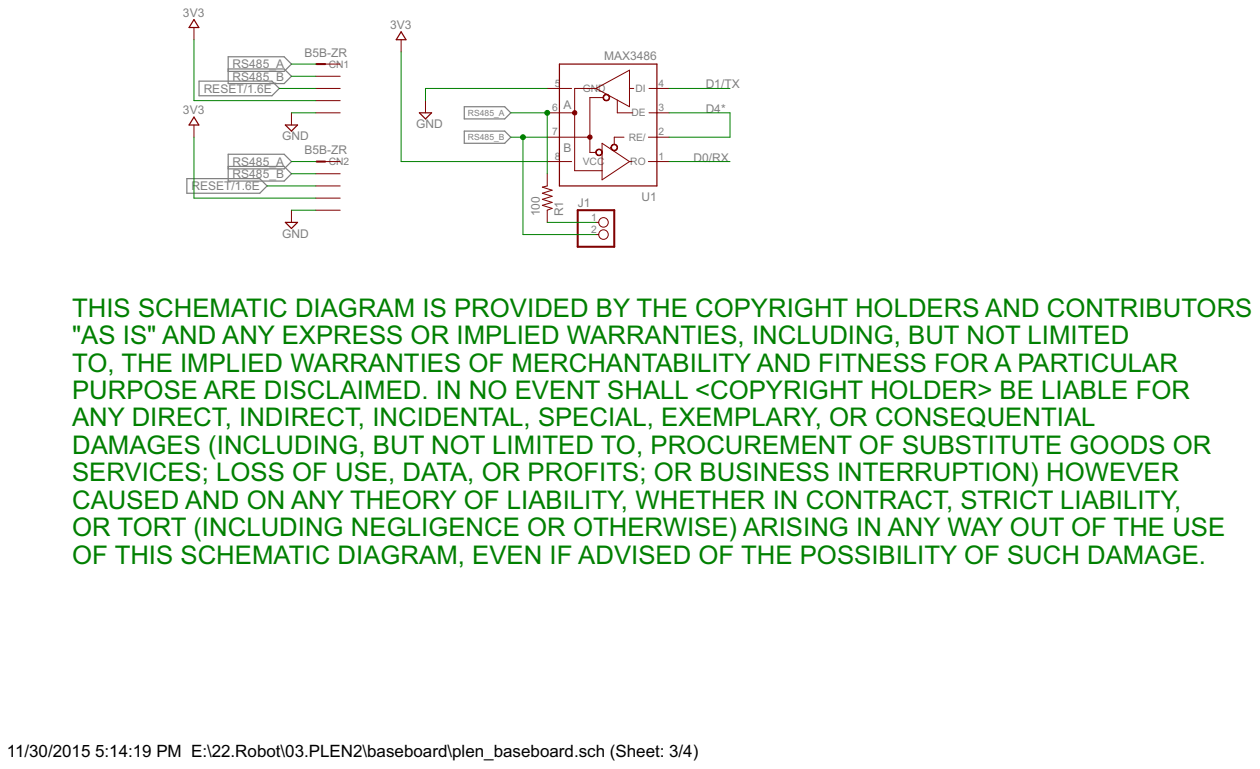
[picture p58: page 3]
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

OF THIS SCHEMATIC DIAGRAM, EVEN IF ADVISED OF THE POSSIBILITY OF SUCH DAMAGE.

11/30/2015 5:14:19 PM E:\22.Robot\03.PLEN2\baseboard\plen_baseboard.sch (Sheet: 3/4)

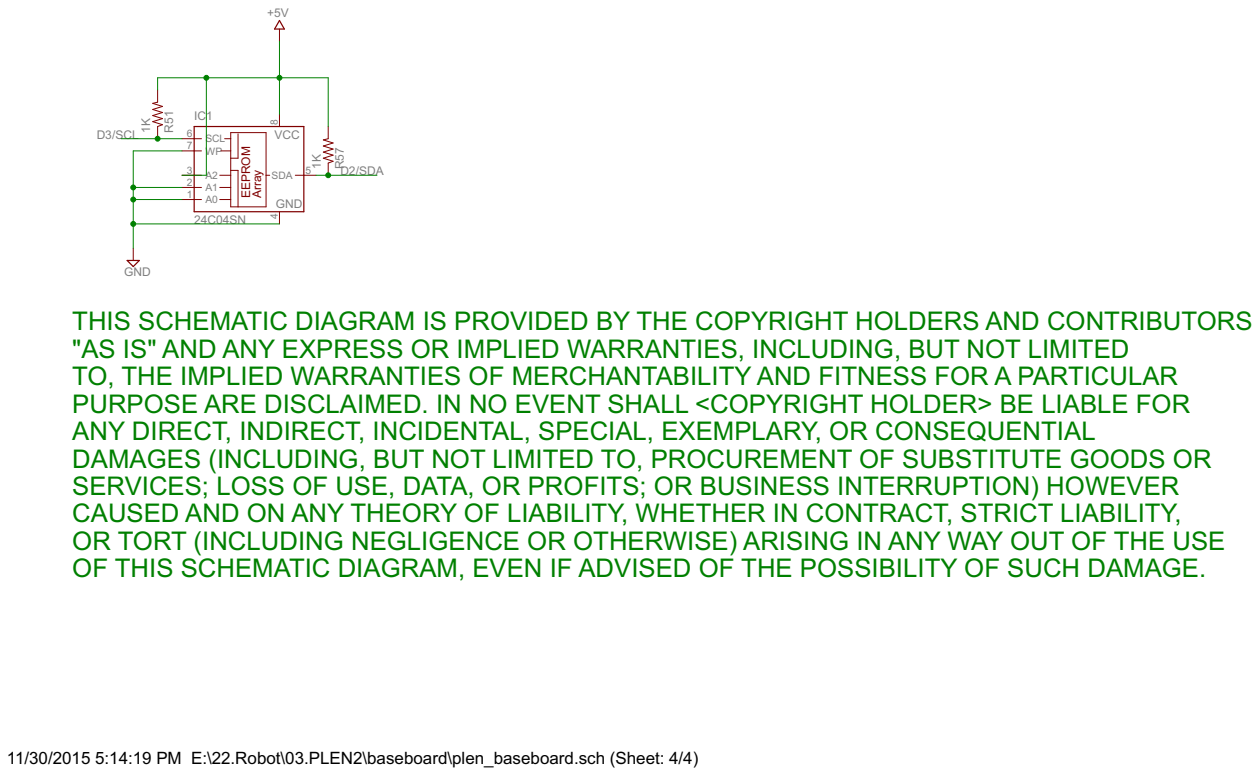
[picture p59: page 4]

GND
THIS SCHEMATIC DIAGRAM IS PROVIDED BY THE COPYRIGHT HOLDERS AND CONTRIBUTORS
"AS IS" AND ANY EXPRESS OR IMPLIED WARRANTIES, INCLUDING, BUT NOT LIMITED
TO, THE IMPLIED WARRANTIES OF MERCHANTABILITY AND FITNESS FOR A PARTICULAR
PURPOSE ARE DISCLAIMED. IN NO EVENT SHALL <COPYRIGHT HOLDER> BE LIABLE FOR
ANY DIRECT, INDIRECT, INCIDENTAL, SPECIAL, EXEMPLARY, OR CONSEQUENTIAL
DAMAGES (INCLUDING, BUT NOT LIMITED TO, PROCUREMENT OF SUBSTITUTE GOODS OR
SERVICES; LOSS OF USE, DATA, OR PROFITS; OR BUSINESS INTERRUPTION) HOWEVER
CAUSED AND ON ANY THEORY OF LIABILITY, WHETHER IN CONTRACT, STRICT LIABILITY, OR TORT (INCLUDING NEGLIGENCE OR OTHERWISE) ARISING IN ANY WAY OUT OF THE USE

OF THIS SCHEMATIC DIAGRAM, EVEN IF ADVISED OF THE POSSIBILITY OF SUCH DAMAGE.

11/30/2015 5:14:19 PM E:\22.Robot\03.PLEN2\baseboard\plen_baseboard.sch (Sheet: 4/4)
