PingguSoft/PLEN2/schematic/headboard/plen_headboard.brd

## EAGLE design schematic/headboard/plen_headboard.brd (2015-12-10)

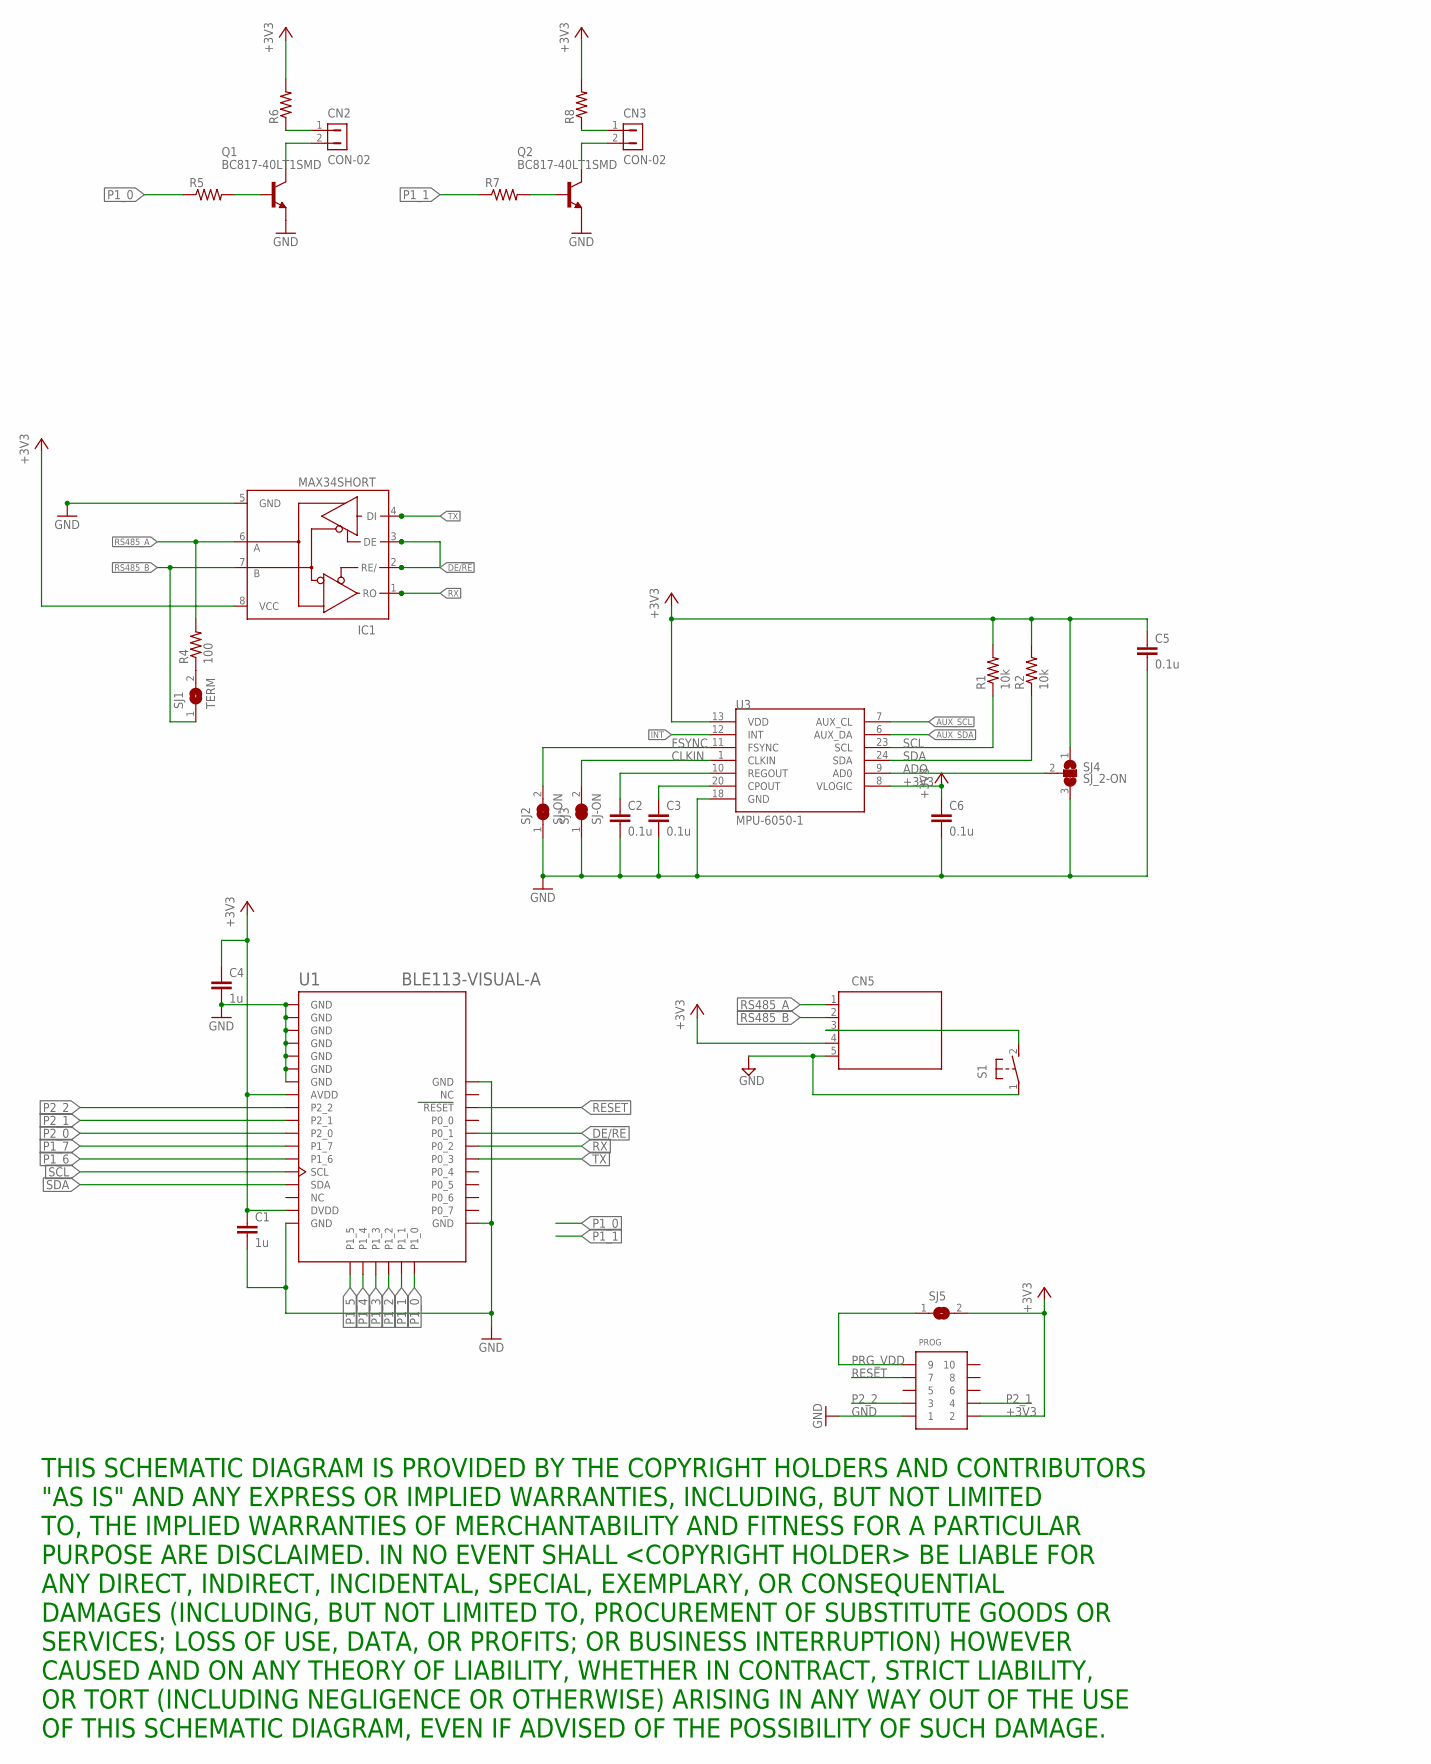
[picture p60: schematic plen_headboard.sch]

Parts:
C1, C4: 1u; C0603
C2, C3, C5, C6: 0.1u; C0603
CN2, CN3: CON-02; SIP-100-02
CN5: 5PINZH; ZH-5
IC1: MAX34SHORT; SO08SHORT
PROG: CONN_5-2-FTSH-V; FTSH-105-DV
Q1, Q2: BC817-40LT1SMD; SOT23-BEC
R1, R2: 10k; R0603
R4: 100; R0603
R5, R6, R7, R8: R-US_R0603; R0603
S1: 31-XX; B3F-31XX
SJ1: TERM; SJ
SJ2, SJ3: SJ-ON
SJ4: SJ_2-ON
SJ5: SJ
U1: BLE113-VISUAL-A; BLE113-A
U3: MPU-6050-1; QFN-24-4MM2

Connections:
+3V3: C1.1, C4.1, C5.1, C6.1, CN5.4, IC1.8 (VCC), PROG.2, R1.2, R2.2, R6.2, R8.2, SJ4.1, SJ5.2, U1.AVDD, U1.DVDD, U3.8 (VLOGIC), U3.13 (VDD)
ADO: SJ4.2, U3.9 (AD0)
AUX_SCL: U3.7 (AUX_CL)
AUX_SDA: U3.6 (AUX_DA)
CLKIN: SJ3.2, U3.1 (CLKIN)
DE/!RE: IC1.2 (RE/), IC1.3 (DE), U1.P0_1
FSYNC: SJ2.2, U3.11 (FSYNC)
GND: C1.2, C2.2, C3.2, C4.2, C5.2, C6.2, CN5.5, IC1.5 (GND), PROG.1, Q1.E, Q2.E, S1.1, SJ2.1, SJ3.1, SJ4.3, U1.GND, U1.GND@2 (GND), U1.GND@3 (GND), U1.GND@4 (GND), U1.GND@5 (GND), U1.GND@6 (GND), U1.GND@7 (GND), U1.GND@8 (GND), U1.GND@9 (GND), U1.GND@10 (GND), U3.18 (GND)
INT: U3.12 (INT)
unnamed: C3.1, U3.20 (CPOUT)
unnamed: C2.1, U3.10 (REGOUT)
unnamed: R4.1, SJ1.2
unnamed: Q1.B, R5.2
unnamed: CN2.2, Q1.C
unnamed: CN2.1, R6.1
unnamed: Q2.B, R7.2
unnamed: CN3.2, Q2.C
unnamed: CN3.1, R8.1
unnamed: CN5.3, S1.2 (S)
P1_0: R5.1, U1.P1_0
P1_1: R7.1, U1.P1_1
P1_2: U1.P1_2
P1_3: U1.P1_3
P1_4: U1.P1_4
P1_5: U1.P1_5
P1_6: U1.P1_6
P1_7: U1.P1_7
P2_0: U1.P2_0
P2_1: PROG.4, U1.P2_1
P2_2: PROG.3, U1.P2_2
PRG_VDD: PROG.9, SJ5.1
RESET: PROG.7, U1.RESET
RS485_A: CN5.1, IC1.6 (A), R4.2
RS485_B: CN5.2, IC1.7 (B), SJ1.1
RX: IC1.1 (RO), U1.P0_2
SCL: R1.1, U1.SCL, U3.23 (SCL)
SDA: R2.1, U1.SDA, U3.24 (SDA)
TX: IC1.4 (DI), U1.P0_3

Notes on the sheet:
THIS SCHEMATIC DIAGRAM IS PROVIDED BY THE COPYRIGHT HOLDERS AND CONTRIBUTORS "AS IS" AND ANY EXPRESS OR IMPLIED WARRANTIES, INCLUDING, BUT NOT LIMITED TO, THE IMPLIED WARRANTIES OF MERCHANTABILITY AND FITNESS FOR A PARTICULAR PURPOSE ARE DISCLAIMED. IN NO EVENT SHALL <COPYRIGHT HOLDER> BE LIABLE FO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

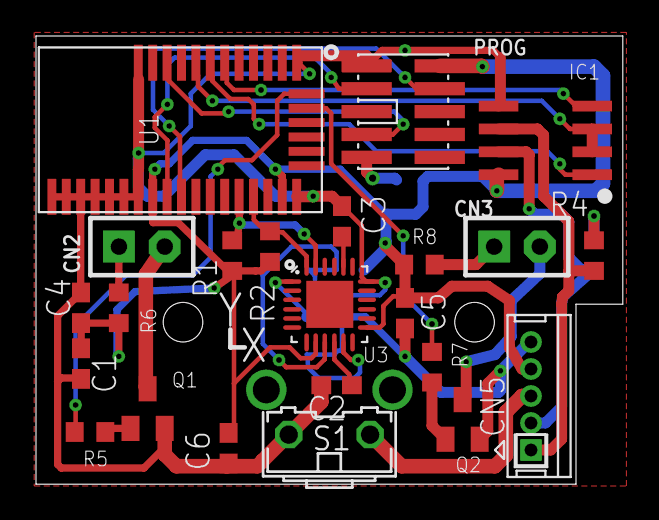
[picture p61: board plen_headboard.brd from above]

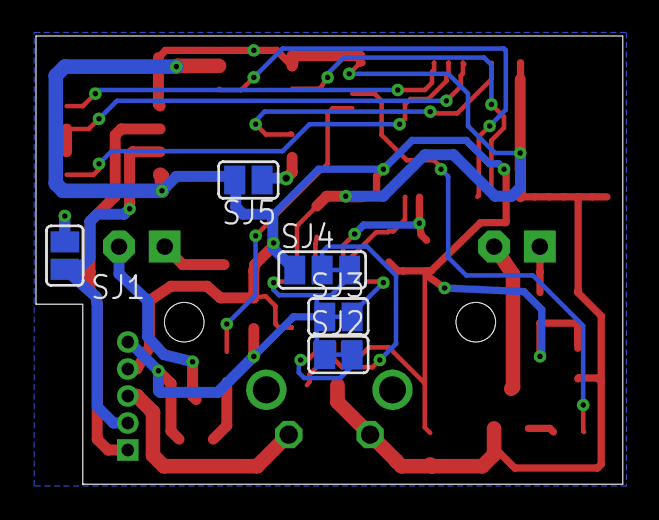
[picture p62: board plen_headboard.brd from below]

Board: 2 copper layers, 32.6 x 24.9 mm, 28 parts (5 on the bottom side), 28 nets.
