PingguSoft/PLEN2/schematic/baseboard/plen_baseboard.brd

## EAGLE design schematic/baseboard/plen_baseboard.brd (2015-11-30)

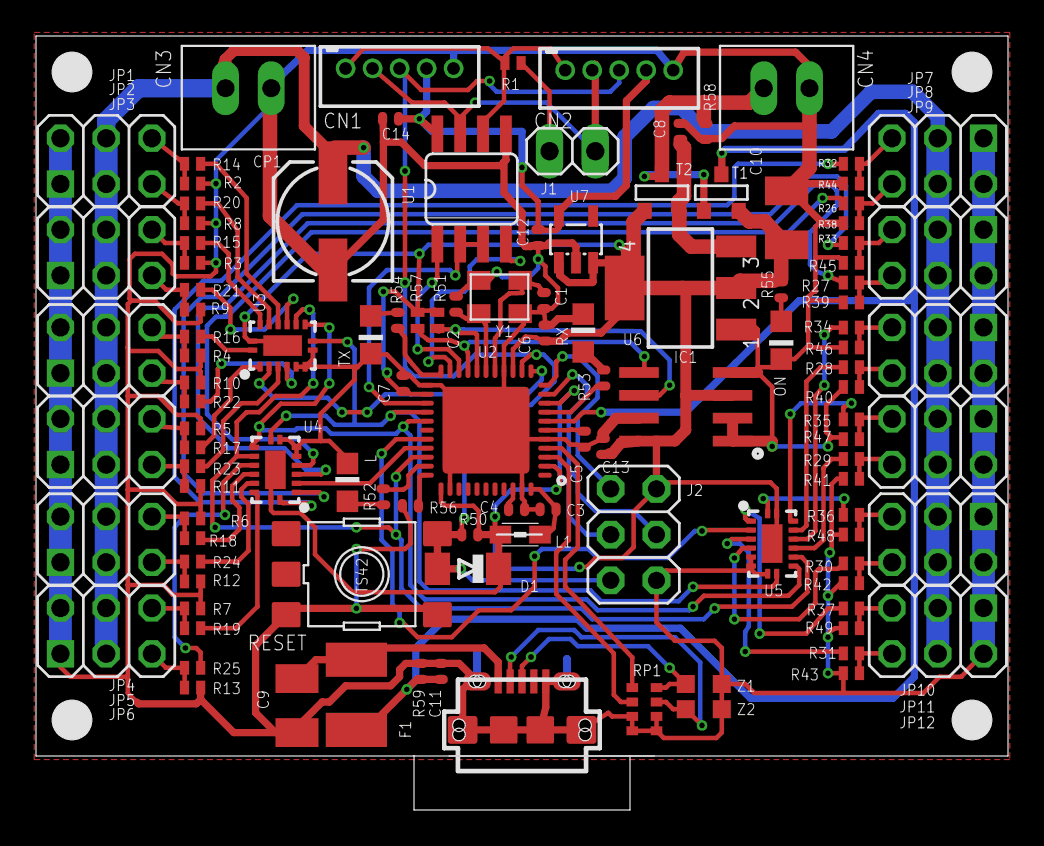
[picture p63: board plen_baseboard.brd from above]

Board: 2 copper layers, 54.0 x 43.0 mm, 120 parts (0 on the bottom side), 91 nets.

Parts:
C1, C2: 22pF; C0402
C3, C5, C12: 1uF; C0402
C4, C6, C7, C8, C11, C13, C14: 100n; C0402
C9, C10: 22u; SMC_B
CN1, CN2: B5B-ZR
CN3, CN4: XH2
CP1: 220u10V; CP_S05-05
D1: CD1206-S01575; MINIMELF
F1: MF-MSMF050-2 500mA; L1812
H1, H2, H3, H4: MOUNT-HOLE2.2; 2,2
IC1: 24C04SN; SO-08
J1: 1X02
J2: 3x2M; 2X03
J3: MYCON2_USB-MINI-B; CON2_USB_MICRO_B_AT
JP1, JP2, JP3, JP4, JP5, JP6, JP7, JP8, JP9, JP10, JP11, JP12: 2X03
L: green; CHIPLED_0805
L1: MH2029-300Y; 0805
ON: red; CHIPLED_0805
R1: 100; R0402S
R2, R3, R4, R5, R6, R7, R8, R9, R10, R11, R12, R13, R14, R15, R16, R17, R18, R19, R20, R21, R22, R23, R24, R25, R26, R27, R28, R29, R30, R31, R32, R33, R34, R35, R36, R37, R38, R39, R40, R41, R42, R43, R44, R45, R46, R47, R48, R49, R51, R57: 1K; R0402S
R50, R56, R58, R59: 10K; R0402
R52, R53, R54, R55: 1K; R0402
RESET: TS42
RP1: 22R; CAY16
RX: yellow; CHIPLED_0805
T1: FDN340P/PMV48XP; SOT-23
T2: PMV48XP; SOT-23
TX: yellow; CHIPLED_0805
U1: MAX3486; SO08
U2: ATMEGA32U4-XUMU; QFN44ML7X7
U3, U4, U5: 4051_EPAD; SOT763-1
U6: NCP1117-5; LINEAR_SOT223
U7: LP2985-33DBVR; SOT23-DBV
U$3: DISCLAIMER
Y1: 16MHz KX-7; CRYSTAL-3.2-2.5
Z1, Z2: CG0603MLC-05E; CT/CN0603

Connections:
3V3: C12.1, C14.1, CN1.4, CN2.4, U1.8, U7.5
+5V: C6.1, C7.1, C10.+, C13.1, D1.C, IC1.3, IC1.8, J2.2, L1.1, R50.1, R51.2, R55.1, R57.2, T1.2, T2.3, U2.2, U2.14, U2.24, U2.34, U3.16, U3.P$17, U4.16, U4.P$17, U5.16, U5.P$17, U6.2, U6.4, U7.1, U7.3
+V1: CN3.1, CP1.+, JP1.3, JP1.4, JP2.3, JP2.4, JP3.3, JP3.4, JP4.3, JP4.4, JP5.3, JP5.4, JP6.3, JP6.4, JP7.3, JP7.4, JP8.3, JP8.4, JP9.3, JP9.4, JP10.3, JP10.4, JP11.3, JP11.4, JP12.3, JP12.4
+VIN: C8.1, T2.2, U6.3
AREF: C4.1, U2.42
AVCC: C3.1, L1.2, U2.44
D0/RX: U1.1, U2.20
D1/TX: U1.4, U2.21
D2/SDA: IC1.5, R57.1, U2.19
D3/SCL: IC1.6, R51.1, U2.18
D4*: U1.2, U1.3, U2.25
D5*: U2.31, U3.11, U4.11, U5.11
D6*: U2.27, U3.10, U4.10, U5.10
D+: J3.P3, RP1.8, Z1.1
D-: J3.P2, RP1.7, Z2.1
GND: C1.1, C2.1, C3.2, C4.2, C5.2, C6.2, C7.2, C8.2, C9.-, C10.-, C11.2, C12.2, C13.2, C14.2, CN1.5, CN2.5, CN3.2, CN4.2, CP1.-, IC1.1, IC1.2, IC1.4, IC1.7, J2.6, J3.P5, J3.S1, J3.S2, J3.S3, J3.S4, J3.S5, J3.S6, J3.S7, J3.S8, J3.S9, J3.S10, JP1.1, JP1.2, JP2.1, JP2.2, JP3.1, JP3.2, JP4.1, JP4.2, JP5.1, JP5.2, JP6.1, JP6.2, JP7.1, JP7.2, JP8.1, JP8.2, JP9.1, JP9.2, JP10.1, JP10.2, JP11.1, JP11.2, JP12.1, JP12.2, L.C, ON.C, R2.1, R3.1, R4.1, R5.1, R6.1, R7.1, R8.1, R9.1, R10.1, R11.1, R12.1, R13.1, R38.1, R39.1, R40.1, R41.1, R42.1, R43.1, R44.1, R45.1, R46.1, R47.1, R48.1, R49.1, R56.2, R58.1, R59.1, RESET.3, RESET.4, RP1.3, RP1.4, RP1.5, RP1.6, RX.C, TX.C, U1.5, U2.5, U2.15, U2.23, U2.35, U2.43, U2.EXP, U3.6, U3.7, U3.8, U4.6, U4.7, U4.8, U5.6, U5.7, U5.8, U6.1, U7.2, Y1.2, Y1.4, Z1.2, Z2.2
HWB: R56.1, U2.33
IO9*: U2.29, U5.3
IO10*: U2.30, U4.3
IO11*: U2.12, U3.3
IO12*: U2.26, U3.9, U4.9, U5.9
IO13*: R52.1, U2.32
MISO: J2.1, U2.11
MOSI: J2.4, U2.10
unnamed: JP1.5, R8.2, R20.1
unnamed: R53.2, RX.A
unnamed: ON.A, R55.2
unnamed: R54.2, TX.A
unnamed: JP1.6, R2.2, R14.1
unnamed: JP3.5, R10.2, R22.1
unnamed: L.A, R52.2
unnamed: JP2.5, R9.2, R21.1
unnamed: JP2.6, R3.2, R15.1
unnamed: JP3.6, R4.2, R16.1
unnamed: JP4.5, R11.2, R23.1
unnamed: JP4.6, R5.2, R17.1
unnamed: JP5.5, R12.2, R24.1
unnamed: JP5.6, R6.2, R18.1
unnamed: JP6.5, R13.2, R25.1
unnamed: JP6.6, R7.2, R19.1
unnamed: JP7.5, R32.2, R44.2
unnamed: JP7.6, R26.2, R38.2
unnamed: JP9.5, R34.2, R46.2
unnamed: JP8.5, R33.2, R45.2
unnamed: JP8.6, R27.2, R39.2
unnamed: JP9.6, R28.2, R40.2
unnamed: JP10.5, R35.2, R47.2
unnamed: JP10.6, R29.2, R41.2
unnamed: JP11.5, R36.2, R48.2
unnamed: JP11.6, R30.2, R42.2
unnamed: JP12.5, R37.2, R49.2
unnamed: JP12.6, R31.2, R43.2
unnamed: J1.1, R1.1
RD+: RP1.1, U2.4
RD-: RP1.2, U2.3
RESET: CN1.3, CN2.3, D1.A, J2.5, R50.2, RESET.2, U2.13
RS485_A: CN1.1, CN2.1, R1.2, U1.6
RS485_B: CN1.2, CN2.2, J1.2, U1.7
RXLED/SS: R53.1, U2.8
SCK: J2.3, U2.9
SRV0: R14.2, U3.13
SRV1: R20.2, U3.14
SRV2: R15.2, U3.15
SRV3: R21.2, U3.12
SRV4: R16.2, U3.1
SRV5: R22.2, U3.5
SRV6: R17.2, U3.2
SRV7: R23.2, U3.4
SRV8: R18.2, U4.13
SRV9: R24.2, U4.14
SRV10: R19.2, U4.15
SRV11: R25.2, U4.12
SRV12: R32.1, U4.1
SRV13: R26.1, U4.5
SRV14: R33.1, U4.2
SRV15: R27.1, U4.4
SRV16: R34.1, U5.13
SRV17: R28.1, U5.14
SRV18: R35.1, U5.15
SRV19: R29.1, U5.12
SRV20: R36.1, U5.1
SRV21: R30.1, U5.5
SRV22: R37.1, U5.2
SRV23: R31.1, U5.4
TXLED: R54.1, U2.22
UCAP: C5.1, U2.6
VIN: CN4.1, R58.2, T1.3, T2.1
VUSB: C11.1, F1.2, R59.2, T1.1, U2.7
VUSBD: C9.+, F1.1, J3.P1
XTAL1: C2.2, U2.17, Y1.3
XTAL2: C1.2, U2.16, Y1.1
