PingguSoft/PLEN2/src/firmware/MotionController.cpp

/*
    Copyright (c) 2015,
    - Kazuyuki TAKASE - https://github.com/Guvalif
    - PLEN Project Company Inc. - https://plen.jp

    This software is released under the MIT License.
    (See also : http://opensource.org/licenses/mit-license.php)
*/

#define DEBUG      true
#define DEBUG_HARD false

#include <Arduino.h>

#include "System.h"
#include "ExternalSD.h"
#include "JointController.h"
#include "Motion.h"
#include "MotionController.h"

#if DEBUG || DEBUG_HARD
    #include "Profiler.h"
#endif


namespace
{
    enum { PRECISION = 16 };

    inline int32_t fixed_cast(int16_t value)
    {
        return (static_cast<int32_t>(value) << PRECISION);
    }

    inline int16_t unfixed_cast(int32_t value)
    {
        return static_cast<int16_t>(value >> PRECISION);
    }
}


PLEN2::MotionController::MotionController(JointController& joint_ctrl)
{
    m_joint_ctrl_ptr = &joint_ctrl;

    m_playing = false;
    m_frame_current_ptr = m_buffer;
    m_frame_next_ptr    = m_buffer + 1;

    for (uint8_t joint_id = 0; joint_id < JointController::JOINTS_SUM; joint_id++)
    {
        m_frame_current_ptr->joint_angle[joint_id] = 0;
    }
}


bool PLEN2::MotionController::playing()
{
    #if DEBUG_HARD
        PROFILING("MotionController::playing()");
    #endif


    return m_playing;
}


bool PLEN2::MotionController::frameUpdatable()
{
    #if DEBUG_HARD
        PROFILING("MotionController::frameUpdatable()");
    #endif


    return m_joint_ctrl_ptr->m_1cycle_finished;
}


bool PLEN2::MotionController::updatingFinished()
{
    #if DEBUG_HARD
        PROFILING("MotionController::updatingFinished()");
    #endif


    return (m_transition_count == 0);
}


bool PLEN2::MotionController::nextFrameLoadable()
{
    #if DEBUG_HARD
        PROFILING("MotionController::nextFrameLoadable()");
    #endif


    if (   (m_header.use_loop)
        || (m_header.use_jump) )
    {
        return true;
    }

    return ((m_frame_next_ptr->index + 1) < m_header.frame_length);
}


void PLEN2::MotionController::play(uint8_t slot)
{
    #if DEBUG
        PROFILING("MotionController::play()");
    #endif


    if (playing())
    {
        #if DEBUG
            System::debugSerial().println(F(">>> error : A motion has been playing."));
        #endif

        return;
    }

    if (slot >= Motion::SLOT_END)
    {
        #if DEBUG
            System::debugSerial().print(F(">>> bad argment : slot = "));
            System::debugSerial().println(static_cast<int>(slot));
        #endif

        return;
    }


    Motion::Header::get(slot, m_header);

    m_setupFrame(0);

    m_playing = true;
}


void PLEN2::MotionController::playFrameDirectly(const Motion::Frame& frame)
{
    #if DEBUG
        PROFILING("MotionController::playDirectly()");
    #endif


    if (playing())
    {
        #if DEBUG
            System::debugSerial().println(F(">>> error : A motion has been playing."));
        #endif

        return;
    }


    m_header.frame_length = 1;
    m_header.use_loop     = 0;
    m_header.use_jump     = 0;

    *m_frame_next_ptr = frame;
    m_frame_next_ptr->index = 0;

    m_transition_count = m_frame_next_ptr->transition_time_ms / Motion::Frame::UPDATE_INTERVAL_MS;

    for (uint8_t joint_id = 0; joint_id < JointController::JOINTS_SUM; joint_id++)
    {
        m_current_fixed_points[joint_id] = fixed_cast(m_frame_current_ptr->joint_angle[joint_id]);

        m_diff_fixed_points[joint_id]  = fixed_cast(m_frame_next_ptr->joint_angle[joint_id])
                                       - m_current_fixed_points[joint_id];

        m_diff_fixed_points[joint_id] /= m_transition_count;
    }

    m_playing = true;
}


void PLEN2::MotionController::willStop()
{
    #if DEBUG
        PROFILING("MotionController::willStop()");
    #endif


    m_header.use_loop = 0;
    m_header.use_jump = 0;
}


void PLEN2::MotionController::stop()
{
    #if DEBUG
        PROFILING("MotionController::stop()");
    #endif


    m_playing = false;
    m_bufferingFrame(); // @attension It is necessary for a valid sequence!
}


void PLEN2::MotionController::updateFrame()
{
    #if DEBUG
        PROFILING("MotionController::updateFrame()");
    #endif


    m_transition_count--;

    for (uint8_t joint_id = 0; joint_id < JointController::JOINTS_SUM; joint_id++)
    {
        m_current_fixed_points[joint_id] += m_diff_fixed_points[joint_id];
        m_joint_ctrl_ptr->setAngleDiff(joint_id, unfixed_cast(m_current_fixed_points[joint_id]));
    }

    m_joint_ctrl_ptr->m_1cycle_finished = false;
}


void PLEN2::MotionController::m_setupFrame(uint8_t index)
{
    Motion::Frame::get(m_header.slot, index, *m_frame_next_ptr);

    m_transition_count = m_frame_next_ptr->transition_time_ms / Motion::Frame::UPDATE_INTERVAL_MS;

    for (uint8_t joint_id = 0; joint_id < JointController::JOINTS_SUM; joint_id++)
    {
        m_current_fixed_points[joint_id] = fixed_cast(m_frame_current_ptr->joint_angle[joint_id]);

        m_diff_fixed_points[joint_id]  = fixed_cast(m_frame_next_ptr->joint_angle[joint_id])
                                       - m_current_fixed_points[joint_id];

        m_diff_fixed_points[joint_id] /= m_transition_count;
    }
}


void PLEN2::MotionController::m_bufferingFrame()
{
    #if DEBUG
        PROFILING("MotionController::m_bufferingFrame()");
    #endif


    Motion::Frame* frame_ptr_temp = m_frame_current_ptr;

    m_frame_current_ptr = m_frame_next_ptr;
    m_frame_next_ptr    = frame_ptr_temp;
}


void PLEN2::MotionController::loadNextFrame()
{
    #if DEBUG
        PROFILING("MotionController::loadNextFrame()");
    #endif


    m_bufferingFrame();
    const uint8_t index_current = m_frame_current_ptr->index;

    #if DEBUG
        System::debugSerial().print(F(">>> index_current : "));
        System::debugSerial().println(static_cast<int>(index_current));

        System::debugSerial().print(F(">>> m_header.frame_length : "));
        System::debugSerial().println(static_cast<int>(m_header.frame_length));
    #endif

    /*!
        @note
        The order of priority of doing built-in functions, is "loop" > "jump".
    */
    if (m_header.use_loop)
    {
        if (index_current >= m_header.loop_end)
        {
            m_setupFrame(m_header.loop_begin);

            if (m_header.loop_count != 255)
            {
                m_header.loop_count--;
            }

            if (m_header.loop_count == 0)
            {
                m_header.use_loop = 0;
            }

            return;
        }
    }

    if (   (!m_header.use_loop)
        && (m_header.use_jump)
        && (index_current >= (m_header.frame_length - 1)) )
    {
        Motion::Header::get(m_header.jump_slot, m_header);

        m_setupFrame(0);

        return;
    }

    m_setupFrame(index_current + 1);
}


void PLEN2::MotionController::dump(uint8_t slot)
{
    #if DEBUG
        PROFILING("MotionController::dump()");
    #endif


    if (slot >= Motion::SLOT_END)
    {
        #if DEBUG
            System::debugSerial().print(F(">>> bad argment : slot = "));
            System::debugSerial().println(static_cast<int>(slot));
        #endif

        return;
    }


    Motion::Header header;
    Motion::Header::get(slot, header);

    System::outputSerial().println(F("{"));

    System::outputSerial().print(F("\t\"slot\": "));
    System::outputSerial().print(static_cast<int>(header.slot));
    System::outputSerial().println(F(","));

    header.name[Motion::Header::NAME_LENGTH - 1] = '\0'; // sanity check.
    System::outputSerial().print(F("\t\"name\": \""));
    System::outputSerial().print(header.name);
    System::outputSerial().println(F("\","));

    System::outputSerial().print(F("\t\"@frame_length\": "));
    System::outputSerial().print(static_cast<int>(header.frame_length));
    System::outputSerial().println(F(","));

    System::outputSerial().println(F("\t\"codes\": ["));

    if (header.use_loop)
    {
        System::outputSerial().println(F("\t\t{"));

        System::outputSerial().println(F("\t\t\t\"method\": \"loop\","));

        System::outputSerial().print(F("\t\t\t\"arguments\": ["));

        System::outputSerial().print(static_cast<int>(header.loop_begin));
        System::outputSerial().print(F(", "));

        System::outputSerial().print(static_cast<int>(header.loop_end));
        System::outputSerial().print(F(", "));

        System::outputSerial().print(static_cast<int>(header.loop_count));

        System::outputSerial().println(F("]"));

        System::outputSerial().print(F("\t\t}"));

        if (header.use_jump)
        {
            System::outputSerial().print(F(","));
        }

        System::outputSerial().println();
    }

    if (header.use_jump == 1)
    {
        System::outputSerial().println(F("\t\t{"));

        System::outputSerial().println(F("\t\t\t\"method\": \"jump\","));

        System::outputSerial().print(F("\t\t\t\"arguments\": ["));

        System::outputSerial().print(static_cast<int>(header.jump_slot));

        System::outputSerial().println(F("]"));

        System::outputSerial().println(F("\t\t}"));
    }

    System::outputSerial().println(F("\t],"));

    System::outputSerial().println(F("\t\"frames\": ["));

    Motion::Frame frame;

    for (uint16_t frame_index = 0; frame_index < header.frame_length; frame_index++)
    {
        Motion::Frame::get(slot, frame_index, frame);

        System::outputSerial().println(F("\t\t{"));

        System::outputSerial().print(F("\t\t\t\"@index\": "));
        System::outputSerial().print(frame_index);
        System::outputSerial().println(F(","));

        System::outputSerial().print(F("\t\t\t\"transition_time_ms\": "));
        System::outputSerial().print(frame.transition_time_ms);
        System::outputSerial().println(F(","));

        System::outputSerial().println(F("\t\t\t\"outputs\": ["));

        for (uint16_t device_index = 0; device_index < JointController::JOINTS_SUM; device_index++)
        {
            System::outputSerial().println(F("\t\t\t\t{"));

            System::outputSerial().print(F("\t\t\t\t\t\"device\": "));
            System::outputSerial().print(device_index);
            System::outputSerial().println(F(","));

            System::outputSerial().print(F("\t\t\t\t\t\"value\": "));
            System::outputSerial().println(frame.joint_angle[device_index]);

            if ((device_index + 1) == JointController::JOINTS_SUM)
            {
                System::outputSerial().println(F("\t\t\t\t}"));
            }
            else
            {
                System::outputSerial().println(F("\t\t\t\t},"));
            }
        }

        System::outputSerial().println(F("\t\t\t]"));

        System::outputSerial().print(F("\t\t}"));

        if ((frame_index + 1) == header.frame_length)
        {
            System::outputSerial().println();
        }
        else
        {
            System::outputSerial().println(F(","));
        }
    }

    System::outputSerial().println(F("\t]"));

    System::outputSerial().println(F("}"));
}
