PingguSoft/PLEN2/src/firmware/firmware.h

/*!
    @file      firmware.h
    @brief     Mainpage's markdown file
    @author    Kazuyuki TAKASE
    @copyright The MIT License - http://opensource.org/licenses/mit-license.php
*/

/*!
    @mainpage

    Firmware for Arduino | PLEN Project Company Inc.
    ===============================================================================

    Code name "Cytisus" (version 1.x.x) is now available!


    ## Attention!
    "Arduino" means Arduino/Genuino Micro (including Atmega32u4) compatible board created by us.
    Please get it [the official shop](https://plen.jp/shop) or create it yourself.


    ## How to Install
    1. Download (and install) Arduino IDE from [arduino.cc website](https://www.arduino.cc/en/Main/Software).
       (Choose your environment, then click "JUST DOWNLOAD" button.)
    2. Download this repository from [here](https://github.com/plenprojectcompany/plen-Firmware_Arduino/archive/master.zip).
    3. Open the [firmware.ino](https://github.com/plenprojectcompany/plen-Firmware_Arduino/blob/master/firmware/firmware.ino) using the Arduino IDE.
    4. Click the upload button (that is like a right arrow).


    ## Copyright (c) 2015,
    - [Kazuyuki TAKASE](https://github.com/Guvalif)
    - [PLEN Project Company Inc.](https://plen.jp)

    ### Special Thanks :)
    - [Laura Domine](https://github.com/Temigo): Contributed to do API guide localization.
    - [tueddy](https://github.com/tueddy): Contributed to put a sense of fun.


    ## API Guide
    Please check [github pages](https://plenprojectcompany.github.io/plen-Firmware_Arduino) of the repository.


    ## Build Environment
    - Windows 8.1 Professional edition
    - Windows 7 Home Premium
    - [Arduino IDE v1.6.5](https://www.arduino.cc/en/Main/OldSoftwareReleases#previous)
    - [Arduino Unit v2.1.1](https://github.com/mmurdoch/arduinounit/releases/tag/v2.1.1)


    ## License
    This software is released under [the MIT License](http://opensource.org/licenses/mit-license.php).
*/
