PingguSoft/PLEN2/src/utility/acc_gyro_logger/acc_gyro_logger.ino

#include "AccelerationGyroSensor.h"
#include "Profiler.h"


namespace
{
	PLEN2::AccelerationGyroSensor acc_gyro;
}


void setup()
{
	while (!Serial);

	delay(3000); //!< @attention BLEチップのファームウェア起動を待つ。
}

void loop()
{
	{
		volatile Utility::Profiler p(F("AccelerationGyroSensor::sampling()"));

		acc_gyro.sampling();
	}

	acc_gyro.dump();
}
