PingguSoft/PLEN2/src/utility/sizeof_checker/sizeof_checker.ino

void setup()
{
	Serial.begin(2000000);

	while (!Serial); // Arduino Micro only.

	Serial.print(F("char  : "));
	Serial.print(sizeof(char));
	Serial.println(F(" byte"));

	Serial.print(F("int   : "));
	Serial.print(sizeof(int));
	Serial.println(F(" byte"));

	Serial.print(F("short : "));
	Serial.print(sizeof(short));
	Serial.println(F(" byte"));

	Serial.print(F("long  : "));
	Serial.print(sizeof(long));
	Serial.println(F(" byte"));

	Serial.print(F("float : "));
	Serial.print(sizeof(float));
	Serial.println(F(" byte"));

	int endianness = 0x01;
	const char* scanner = (const char*)&endianness;

	Serial.print(F("Endianness : "));
	Serial.println((scanner[0])? "little" : "big");
}


void loop()
{
	// noop.
}
