PingguSoft/PLEN2/(commit log)

2015-11-30 PLEN2 initial upload
    [plen_baseboard.brd, plen_baseboard.sch]
2015-11-30 folder rearrangement
    [PLEN2.stl, TJ_es08md_horn.stl, barb.stl, body_middle.stl, body_middle_test.stl, body_rear.stl, chest_0_05.stl, chest_0_12.stl]
2015-12-10 source update to 1.3.0
    [plen_headboard.brd, plen_headboard.sch]
2016-12-06 use sdcard instead of eeprom
    [plen2_controlboard.sch]
2016-12-08 change timer1 to mode14
2016-12-09 make servo period configuable
2016-12-16 ble added
    [plen2_arduino.sch]
