PingguSoft/PLEN2/(notices)

Notices in the files:
src/firmware/SdInfo.h:
This Library is free software: you can redistribute it and/or modify
it under the terms of the GNU General Public License as published by
the Free Software Foundation, either version 3 of the License, or
(at your option) any later version.
parts and their libraries:
con-headers-jp: Copyright (C) 2004, Bob Starr (rtzaudio@mindspring.com)
